Xpitfire/strido/assistant/test/fixtures/content/docs/electronics.md

---
outline: deep
---

# Electronics, wiring and power

The robot has a servo domain and a logic domain.

<ClientOnly><PartsShop /></ClientOnly>

## Ratings and why these parts

| Element | Rating |
|---|---|
| Main fuse (ATO) | 25 A, protects the servo branch trunk |

See the [wiring check](verification/wiring.md#summary).

### Step 6 – Servo UBECs

Two UBECs feed the servos.

```bash
## not a heading
```

## Safety rules

::: warning Never charge unattended
Charge LiPo packs in a bag.
:::
