Xpitfire/strido/assistant/test/fixtures/content/de/docs/electronics.md

# Elektronik, Verdrahtung und Stromversorgung {#electronics-wiring-and-power}

Der Roboter hat einen Servo- und einen Logikzweig.

## Nennwerte und Teilewahl {#ratings-and-why-these-parts}

Die Hauptsicherung (25 A) schützt den Servozweig.
