Xpitfire/strido/docs/catalog.md

# Parts catalogue

> **Status:** generated from the verified CAD assembly and `hardware/bom.yaml` (`make catalog`). Prices are observed offers (EUR incl. VAT, 2026-10-30); re-check before ordering.

**[Download the catalogue & assembly book (A4 PDF)](catalog/strido-catalog.pdf)** — printed parts, purchased parts, hardware bags drawn at 1:1, the shopping plan, tools, every assembly step, wiring and the software appendix.

<ClientOnly><PartsCatalog /></ClientOnly>

Machine-readable: `docs/catalog/parts.json` (also served by the `strido-hardware` MCP server). Items that are not modelled in the CAD (wire, servo extensions, fuses, filament, tape) are listed in the [BOM](bom/README.md).
