Xpitfire/strido/docs/images/exploded.png

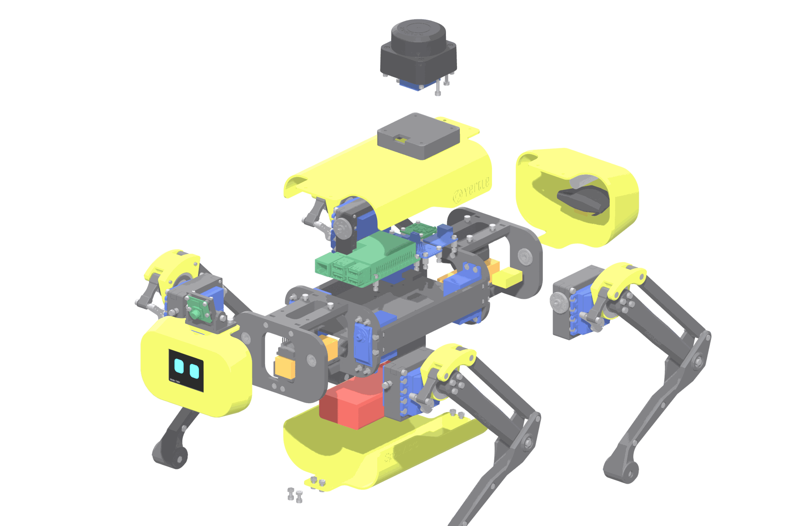
docs/images/exploded.png
