Xpitfire/strido/docs/images/front.png

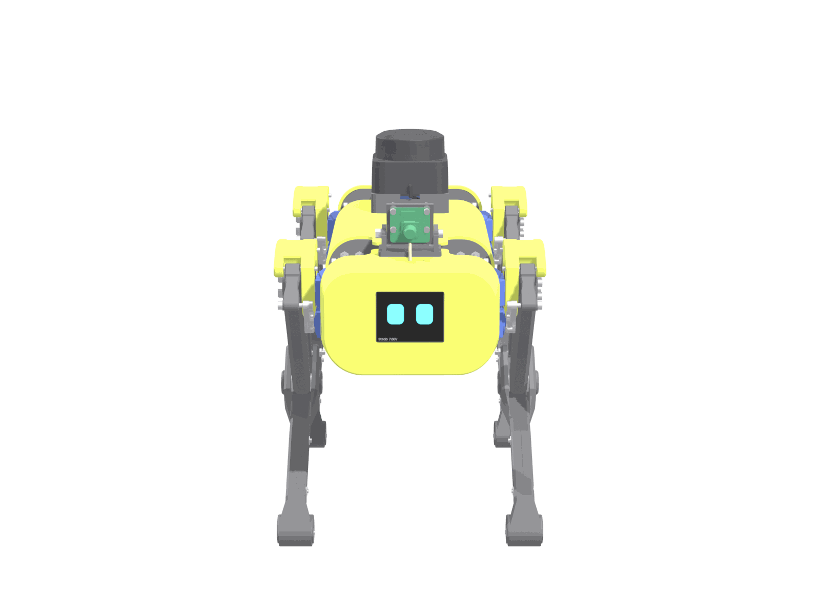
docs/images/front.png
