Xpitfire/strido/docs/images/hero_rear.png

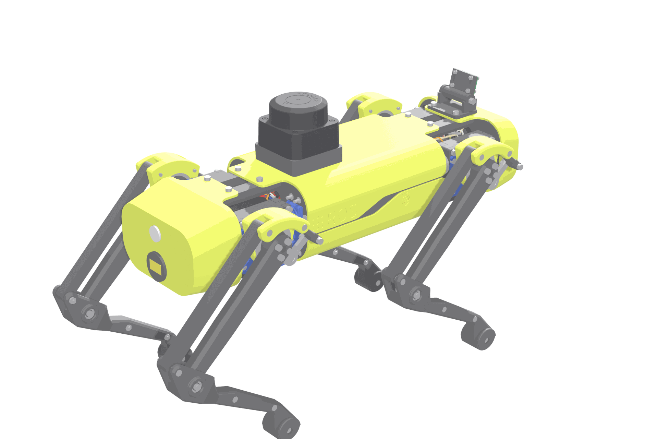
docs/images/hero_rear.png
