Xpitfire/strido/docs/images/section_side.png

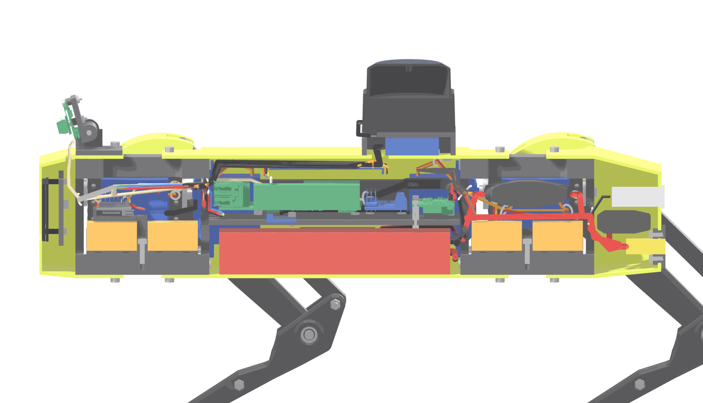
docs/images/section_side.png
