Xpitfire/strido/docs/images/section_top.png

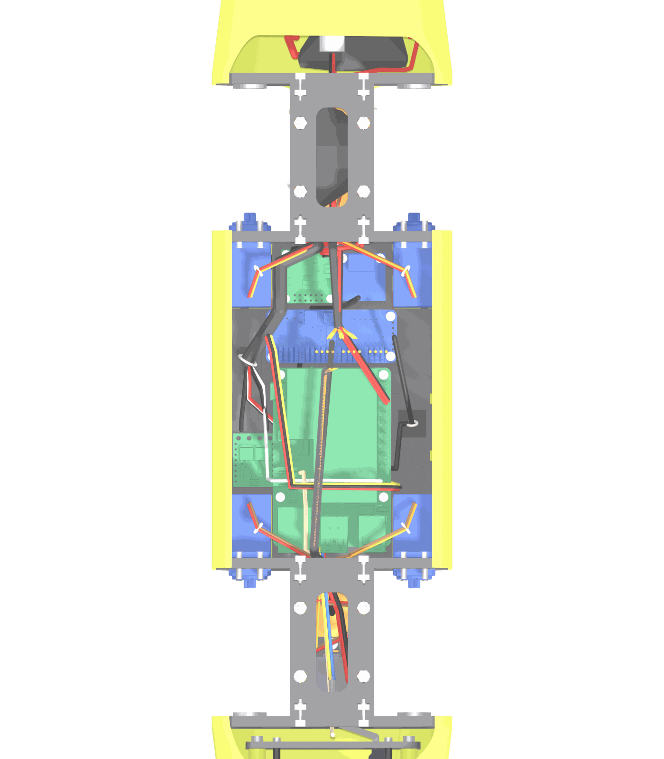
docs/images/section_top.png
