Xpitfire/strido/docs/images/xray_top.png

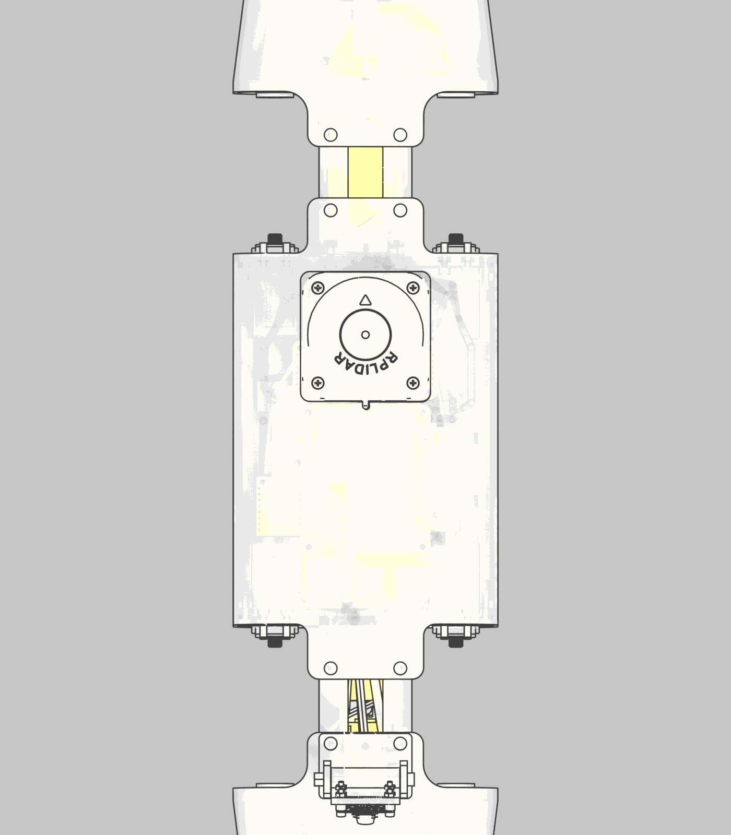
docs/images/xray_top.png
