Xpitfire/strido/docs/viewer/face.png

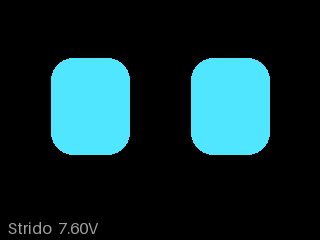
docs/viewer/face.png
