Xpitfire/strido/hardware/print/plates/plate_graphite_07.3mf

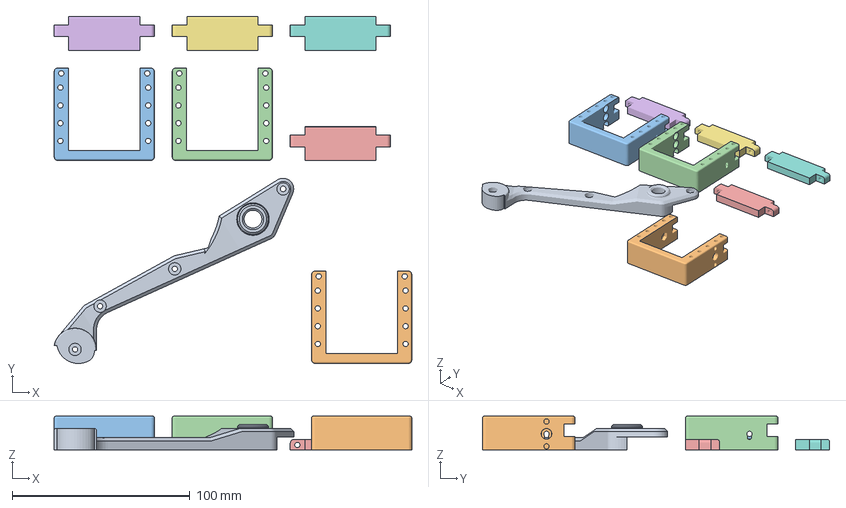
[picture p14: CAD file, 2026-11-10]
hardware/print/plates/plate_graphite_07.3mf
201.2 x 195.2 x 19.0 mm
geometry_0
left_servo_mount_fl.stl
Right_Servo_Mount.stl
right_servo_mount_fr.stl
Servo_Mount_Top_Bracket.stl
Servo_Mount_Top_Bracket.stl_1
Servo_Mount_Top_Bracket.stl_2
Servo_Mount_Top_Bracket.stl_3
