Xpitfire/strido/hardware/print/stl/right_servo_mount.stl

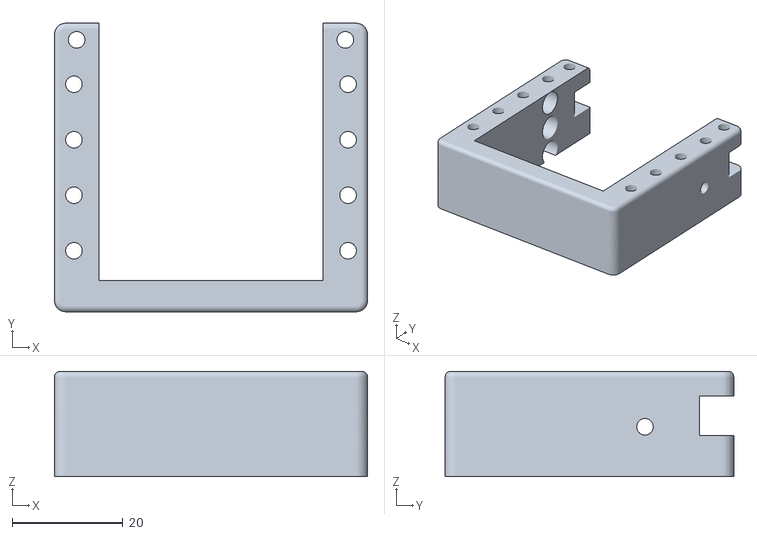
[picture p15: CAD file, 2026-11-10]
hardware/print/stl/right_servo_mount.stl
56.4 x 52.0 x 19.0
