Xpitfire/strido/packages/strido-ntx/src/strido_ntx/robots/models/meshes/RL_calf.stl

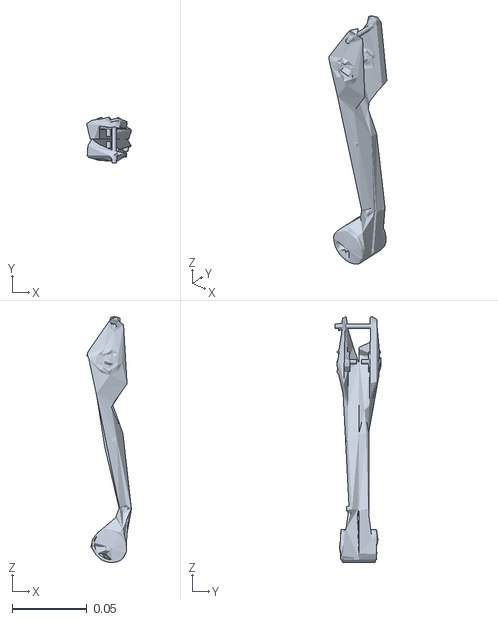
[picture p16: CAD file, 2026-11-10]
packages/strido-ntx/src/strido_ntx/robots/models/meshes/RL_calf.stl
0.03 x 0.0308 x 0.164
