Xpitfire/strido/ros2/strido_description/meshes/RR_thigh.stl

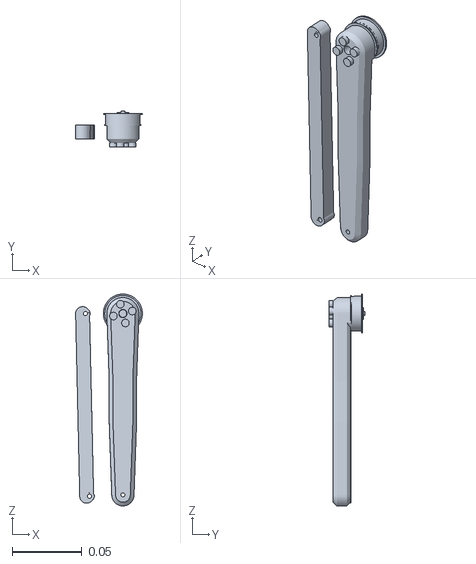
[picture p17: CAD file, 2026-11-10]
ros2/strido_description/meshes/RR_thigh.stl
0.0479 x 0.0258 x 0.152
