Xpitfire/strido/upstream/yertle/design/CAD/Yertle_Single_v2.step

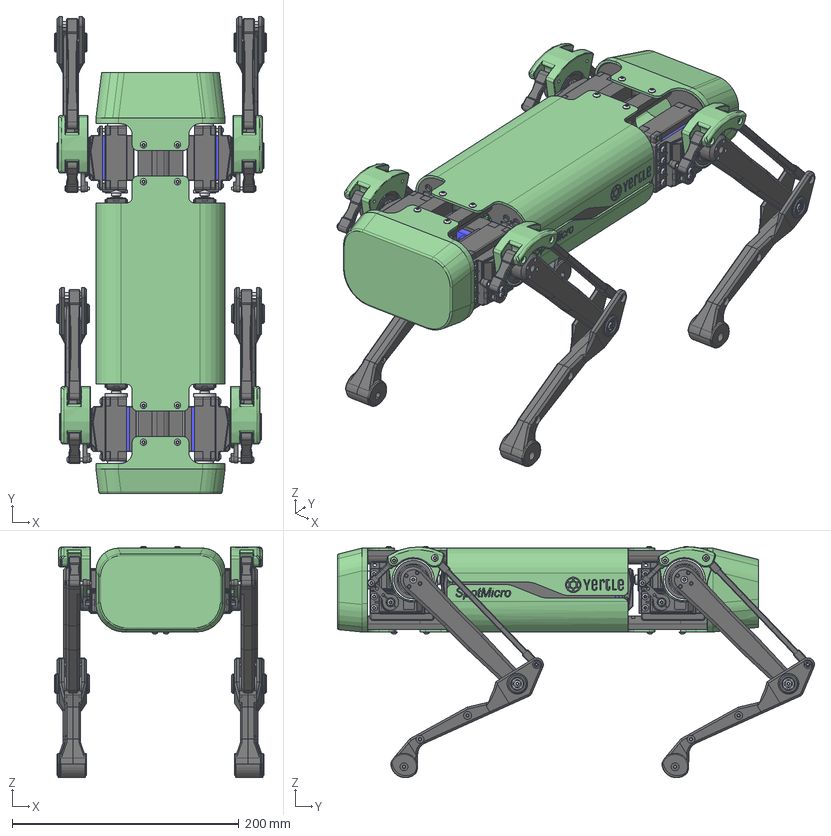
[picture p18: CAD file, 2026-11-10]
upstream/yertle/design/CAD/Yertle_Single_v2.step
187.2 x 421.1 x 204.3 mm
Bottom_Cover_Template
Top_Cover_Template
Rear_Cover (Template)
Rear_Cover (Template)_1
M3 screw x 46
Circuitry_Mountingplate (Template)
PCB, RPi4ModelB
Broadcom BCM2711B0 CPU, RPi4ModelB
2.54 mm DUPONT MALE PIN HEADER, POE, 2X2, RPi4ModelB
2.54 mm DUPONT MALE PIN HEADER, IO, 2X20, RPi4ModelB
Camera Connector, RPi4ModelB
Microphone Plug, RPi4ModelB
Display Connector, RPi4ModelB
Gigabit Ethernet Port, RPi4ModelB
Female Micro HDMI Connector, RPi4ModelB x 2
Female USB Type C Connector, RPi4ModelB
2X USB3.0 PORTS, RPi4ModelB
91D77 D9WHV 778K, 4 GB LPDDR4 SDRAM, RPi4ModelB
Cypress CYW43455 Wireless Module Cover, RPi4ModelB
SD Card Slot, RPi4ModelB
VIA VL805 PCIe USB 3.0 controller, RPi4ModelB
2X USB2.0 PORTS, RPi4ModelB
Broadcom BCM54213PE Gigabit Ethernet Transceiver, RPi4ModelB
MxL7704 Universal PMIC, RPi4ModelB
PCA9685_1
Turnigy_5000mAh_4S__nano_tech_Lipo_Battery
10mm Spacer x 8
UBEC
rodend 5mm big x 2
bl leg_assem_servoholder Bearing right
Shoulder_Joint_Ball_Bearing_Pin x 2
servo_blue x 6
servo arm round x 4
Short Rod
femur right x 2
37mm bearing v3 x 2
Arm Metal Standard x 2
28mm link rod x 2
bushing x 4
bearing_13mm x 4
M3 screw v2 x 6
socket button head cap screw_am_B18.3.4M - 3 x 0.5 x 12 SBHCS --N x 4
bl leg_assem_servoholder Bearing left
Top_Shoulder x 2
Inner_Shoulder x 2
bearing_16m x 4
Chassis_Side x 2
Bottom_Shoulder x 2
rodend 5mm big_1 x 2
bl leg_assem_servoholder Bearing right v8
Shoulder_Joint_Ball_Bearing_Pin v4
servo_blue v1
servo arm round v2
Short Rod_1
femur right v21
37mm bearing v3_1
M3 screw v2 (1)
servo_blue v1 (1)
servo_blue v1 (2)
Arm Metal Standard v2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
