Xpitfire/strido/upstream/yertle/design/STL/Frame/Lower_Shoulder_Frame.stl

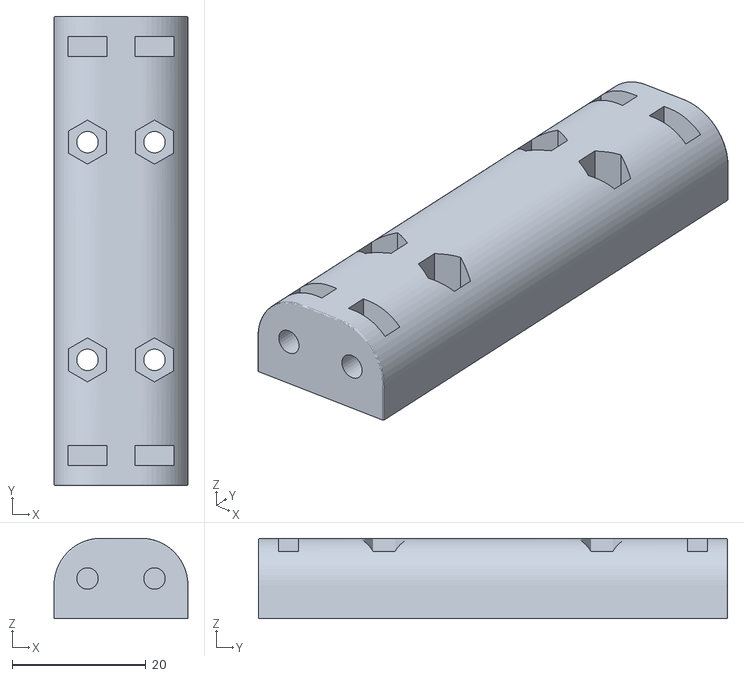
[picture p19: CAD file, 2026-11-10]
upstream/yertle/design/STL/Frame/Lower_Shoulder_Frame.stl
20.0 x 70.0 x 12.0
