Xpitfire/strido/upstream/yertle/design/STL/Legs/Inner_Tibia.stl

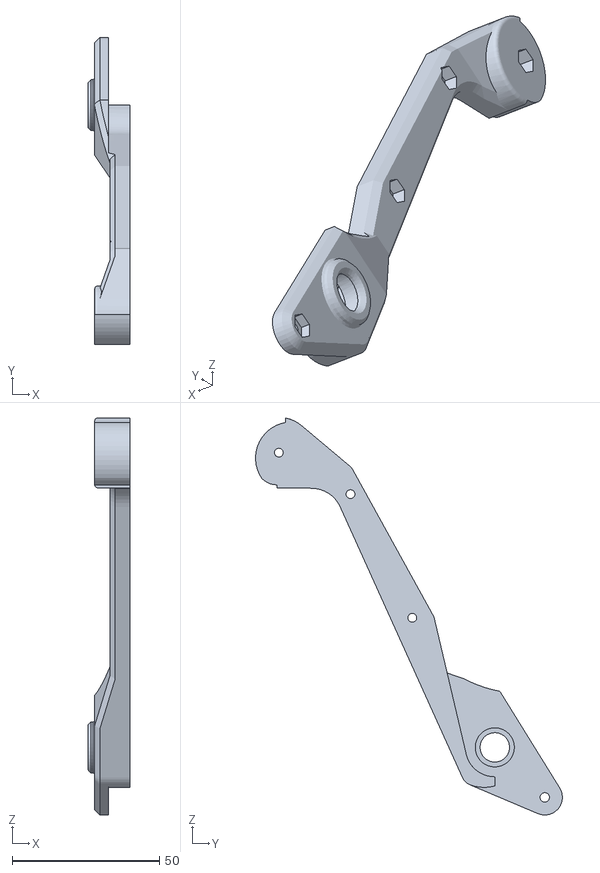
[picture p20: CAD file, 2026-11-10]
upstream/yertle/design/STL/Legs/Inner_Tibia.stl
14.4 x 104.2 x 134.8
