Xpitfire/strido/upstream/yertle/design/STL/Shell/Bottom_Shell.stl

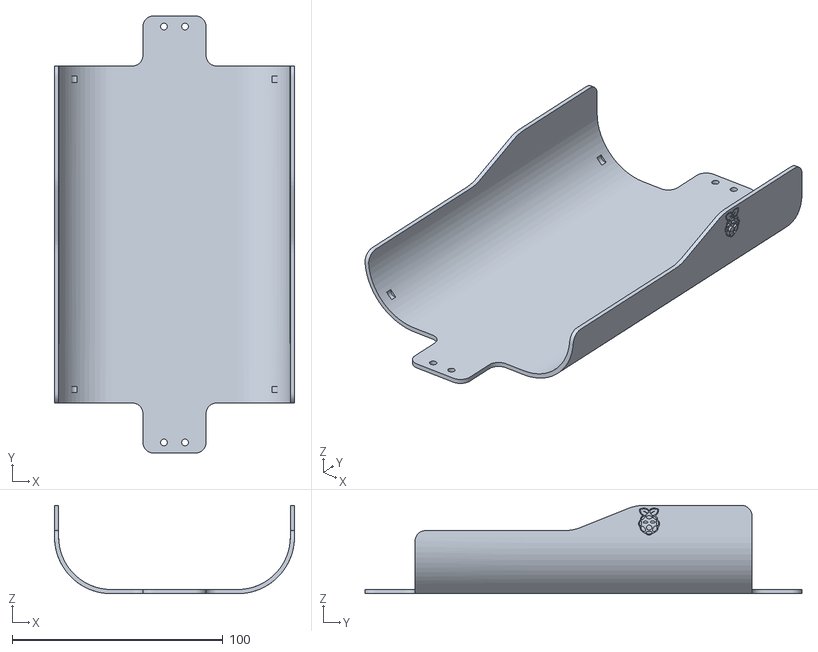
[picture p21: CAD file, 2026-11-10]
upstream/yertle/design/STL/Shell/Bottom_Shell.stl
114.0 x 207.5 x 42.0
