Xpitfire/strido/upstream/yertle/simulation/meshes/lb_shoulder.obj

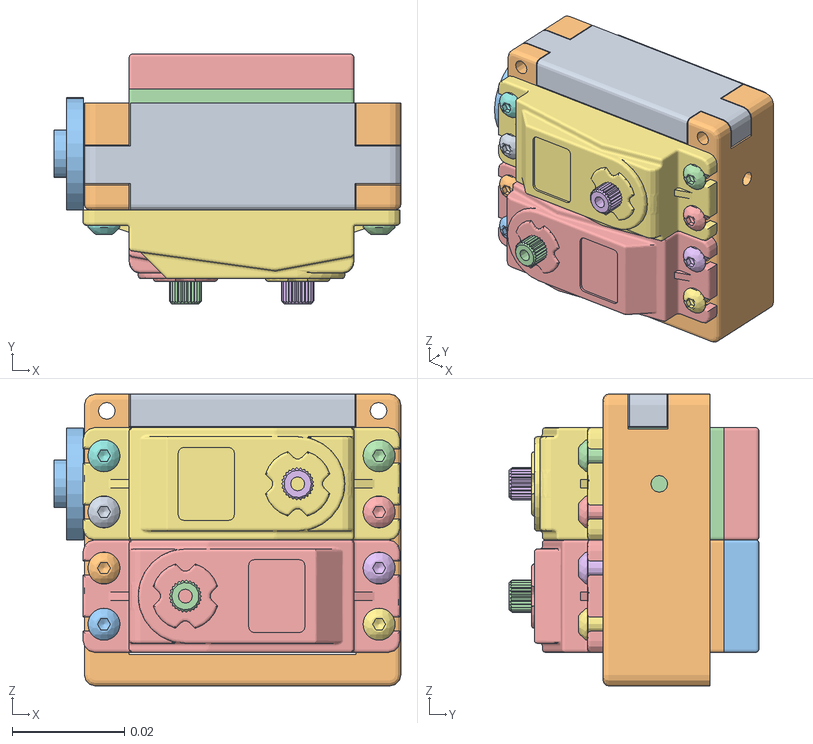
[picture p22: CAD file, 2026-11-10]
upstream/yertle/simulation/meshes/lb_shoulder.obj
0.0618 x 0.0445 x 0.052
