Xpitfire/strido/hardware/print/plates/plate_lime_01.3mf

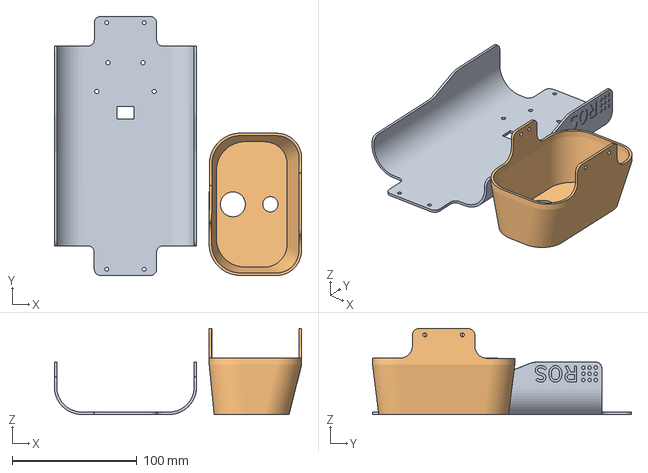
[picture p23: CAD file, 2026-11-10]
hardware/print/plates/plate_lime_01.3mf
198.2 x 207.5 x 68.9 mm
top_shell_sensor.stl
back_shell_button.stl
