Xpitfire/strido/hardware/print/stl/display_bracket.stl

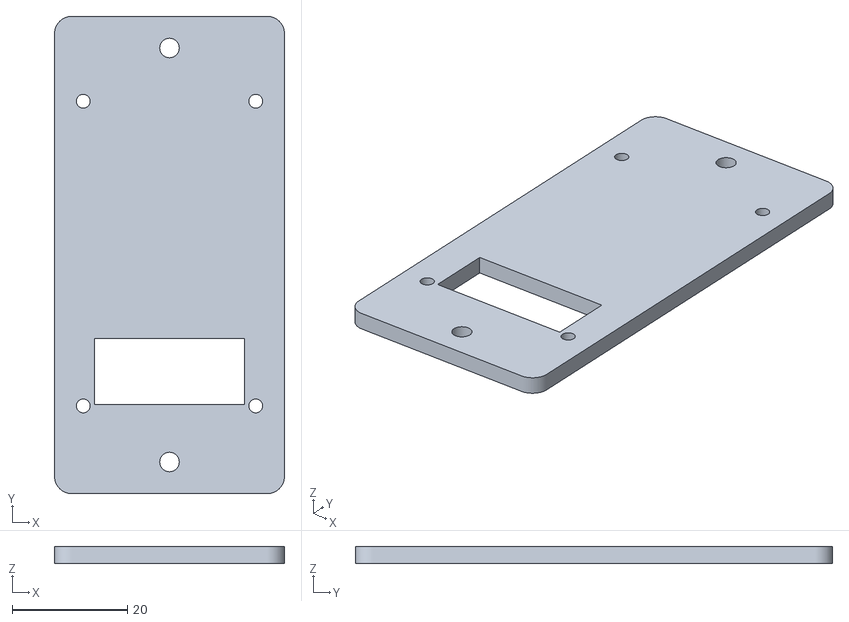
[picture p24: CAD file, 2026-11-10]
hardware/print/stl/display_bracket.stl
40.0 x 83.0 x 3.00
