Xpitfire/strido/packages/strido-ntx/src/strido_ntx/robots/models/meshes/RR_hip.stl

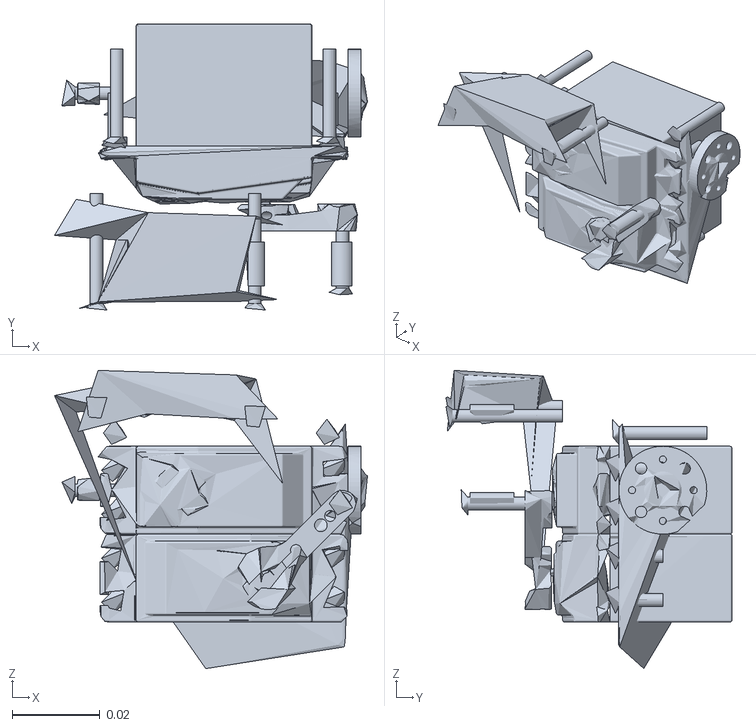
[picture p25: CAD file, 2026-11-10]
packages/strido-ntx/src/strido_ntx/robots/models/meshes/RR_hip.stl
0.0712 x 0.0651 x 0.0678
