Xpitfire/strido/ros2/strido_description/meshes/RR_calf.stl

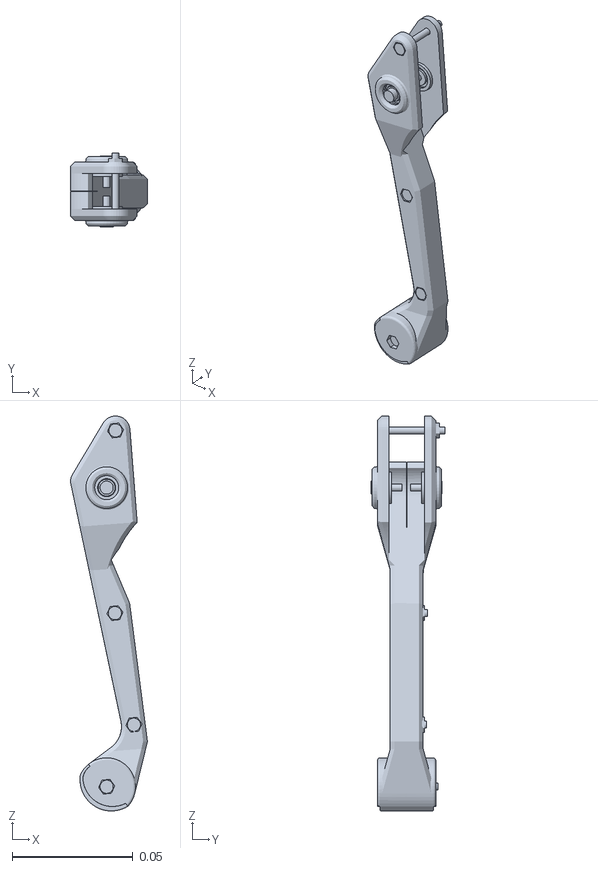
[picture p26: CAD file, 2026-11-10]
ros2/strido_description/meshes/RR_calf.stl
0.0319 x 0.0308 x 0.164
