Xpitfire/strido/upstream/yertle/design/STL/Legs/Left_Shoulder.stl

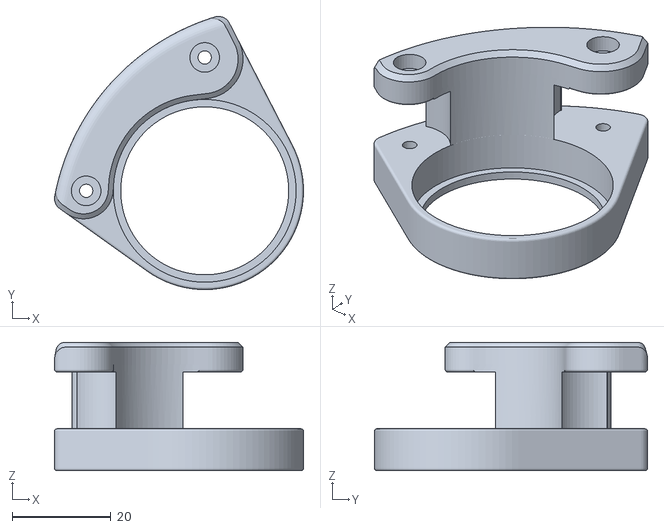
[picture p27: CAD file, 2026-11-10]
upstream/yertle/design/STL/Legs/Left_Shoulder.stl
50.4 x 55.3 x 26.0
