Xpitfire/strido/upstream/yertle/design/STL/Shell/Back_Shell.stl

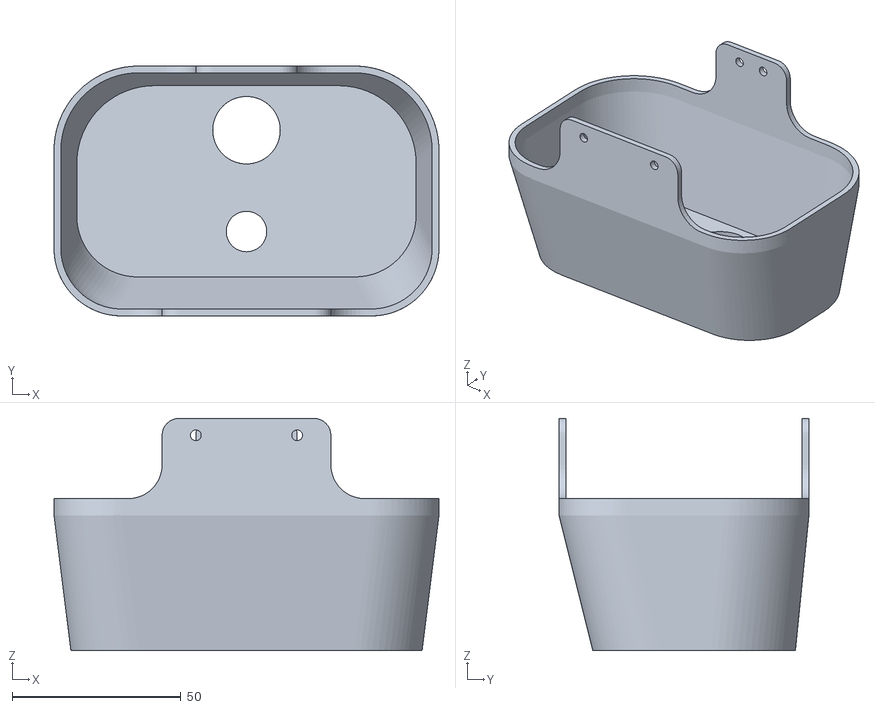
[picture p28: CAD file, 2026-11-10]
upstream/yertle/design/STL/Shell/Back_Shell.stl
114.0 x 74.0 x 68.8
