Xpitfire/strido/hardware/print/plates/plate_graphite_02.3mf

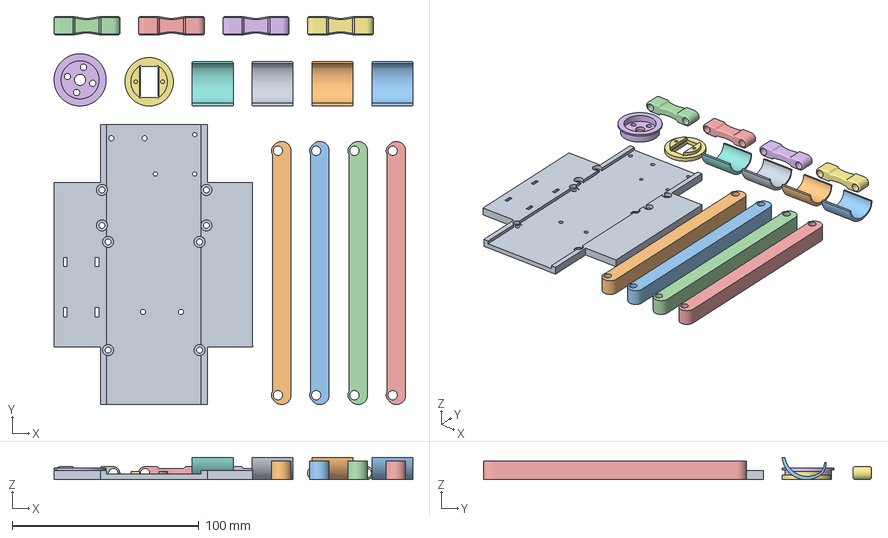
[picture p29: CAD file, 2026-11-10]
hardware/print/plates/plate_graphite_02.3mf
192.4 x 208.0 x 12.0 mm
electronics_deck.stl
stiff_long_link.stl
stiff_long_link.stl_1
stiff_long_link.stl_2
stiff_long_link.stl_3
Femur_Servo_Connector.stl
arming_port_bezel.stl
0196.stl
0196.stl_1
0196.stl_2
0196.stl_3
Short_Link.stl
Short_Link.stl_1
Short_Link.stl_2
Short_Link.stl_3
