Xpitfire/strido/hardware/print/stl/top_shell_sensor.stl

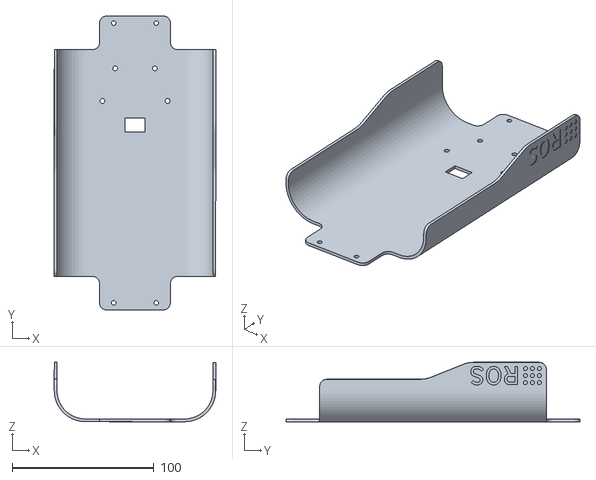
[picture p30: CAD file, 2026-11-10]
hardware/print/stl/top_shell_sensor.stl
114.0 x 207.5 x 42.1
