Xpitfire/strido/packages/strido-ntx/src/strido_ntx/robots/models/meshes/RR_thigh.stl

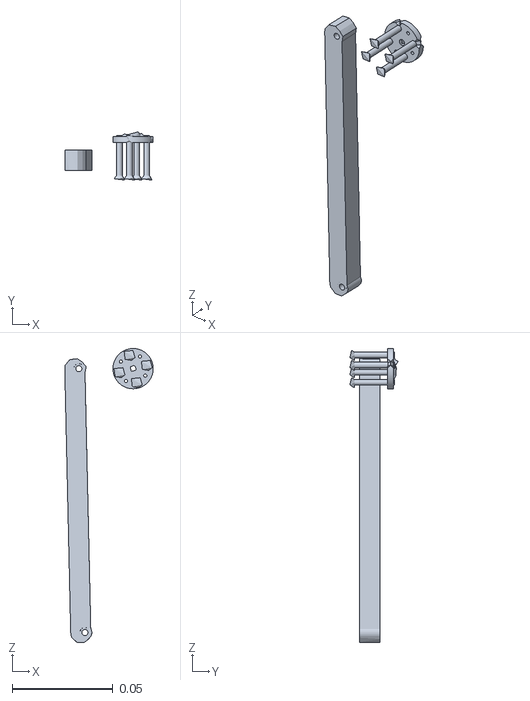
[picture p31: CAD file, 2026-11-10]
packages/strido-ntx/src/strido_ntx/robots/models/meshes/RR_thigh.stl
0.0439 x 0.024 x 0.146
