Xpitfire/strido/ros2/strido_description/meshes/RL_hip.stl

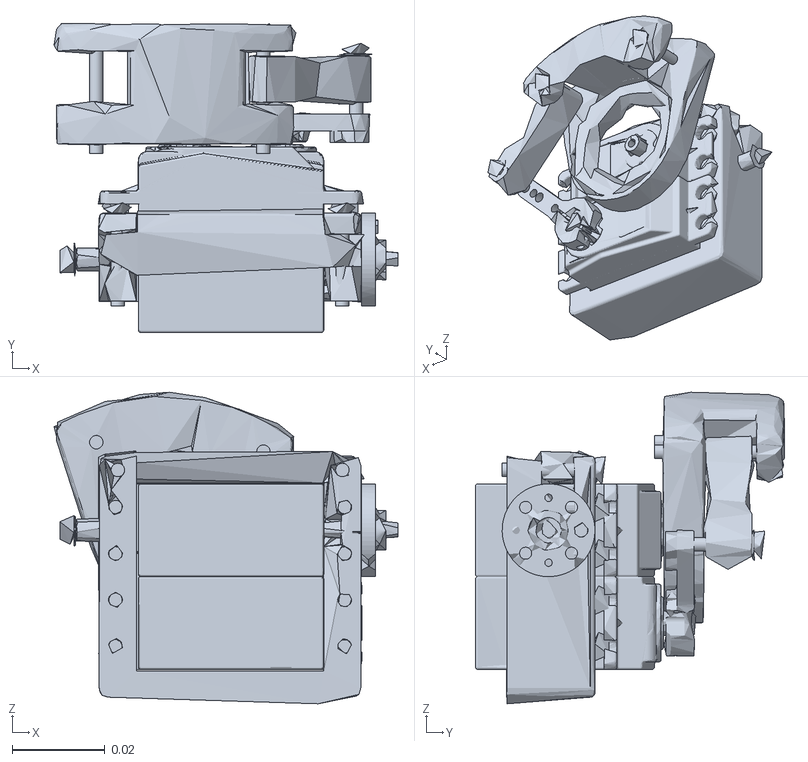
[picture p32: CAD file, 2026-11-10]
ros2/strido_description/meshes/RL_hip.stl
0.0742 x 0.0666 x 0.0672
