Xpitfire/strido/upstream/yertle/design/STL/Frame/Upper_Shoulder_Frame.stl

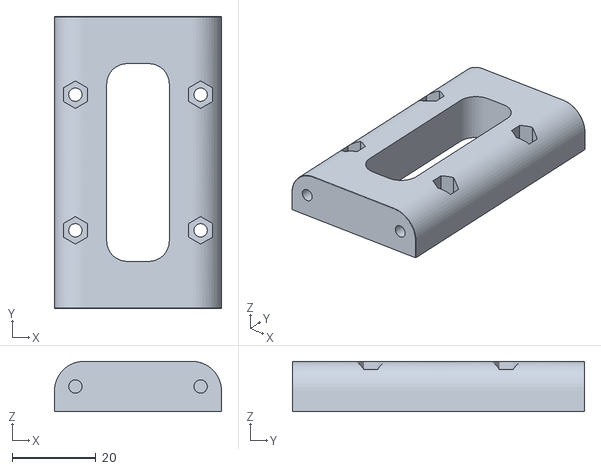
[picture p33: CAD file, 2026-11-10]
upstream/yertle/design/STL/Frame/Upper_Shoulder_Frame.stl
40.0 x 70.0 x 12.0
