Xpitfire/strido/upstream/yertle/design/STL/Legs/Femur_Servo_Connector.stl

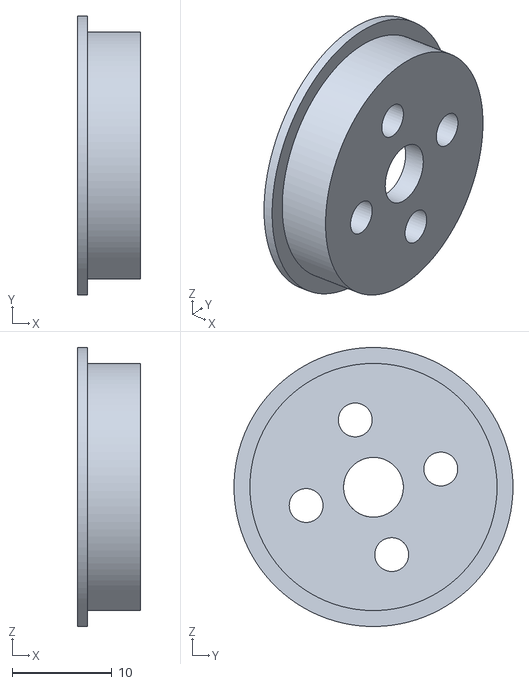
[picture p34: CAD file, 2026-11-10]
upstream/yertle/design/STL/Legs/Femur_Servo_Connector.stl
6.32 x 28.0 x 28.0
