Xpitfire/strido/upstream/yertle/design/STL/Shell/Top_Shell.stl

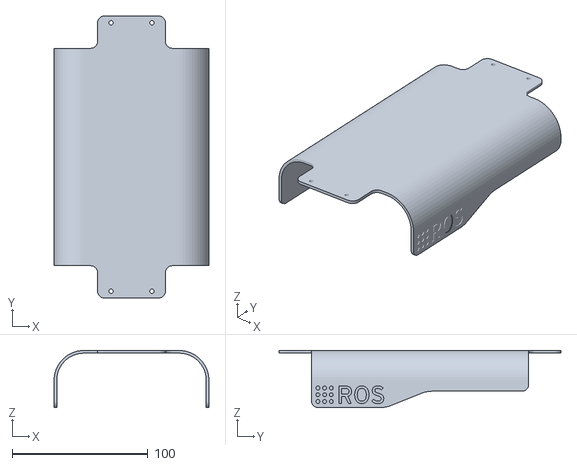
[picture p35: CAD file, 2026-11-10]
upstream/yertle/design/STL/Shell/Top_Shell.stl
114.0 x 207.5 x 42.0
