Xpitfire/strido/hardware/print/plates/plate_graphite_08.3mf

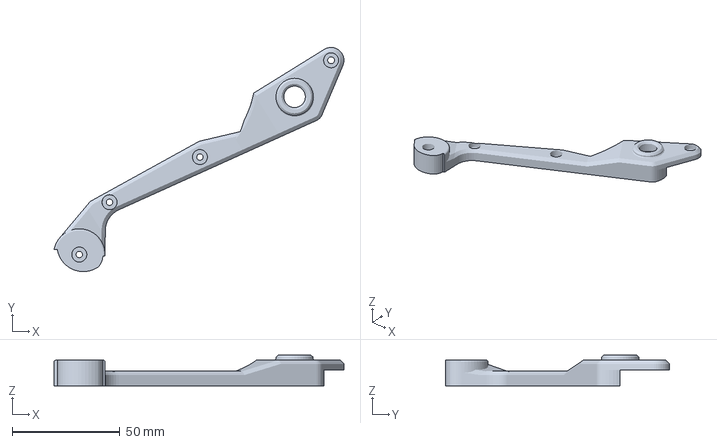
[picture p36: CAD file, 2026-11-10]
hardware/print/plates/plate_graphite_08.3mf
134.8 x 104.2 x 14.4 mm
