Xpitfire/strido/hardware/print/stl/short_link.stl

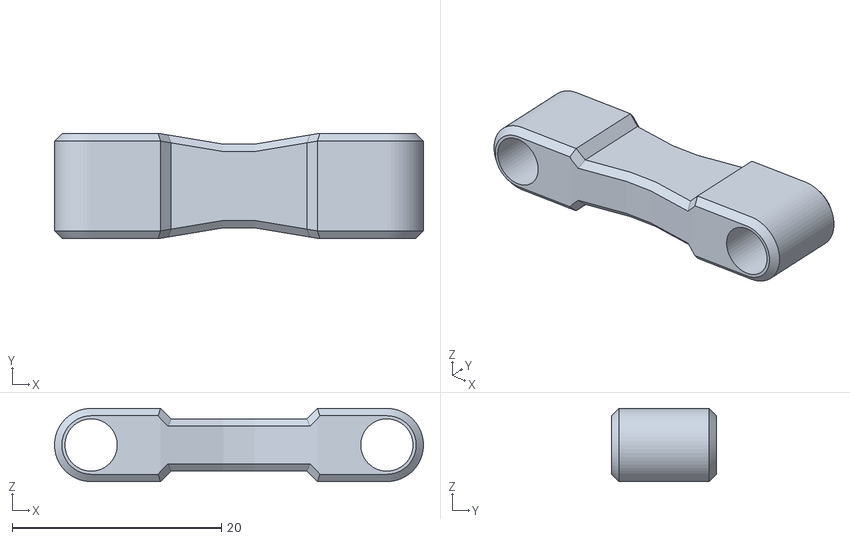
[picture p37: CAD file, 2026-11-10]
hardware/print/stl/short_link.stl
35.3 x 10.0 x 7.00
