Xpitfire/strido/packages/strido-ntx/src/strido_ntx/robots/models/meshes/FR_hip.stl

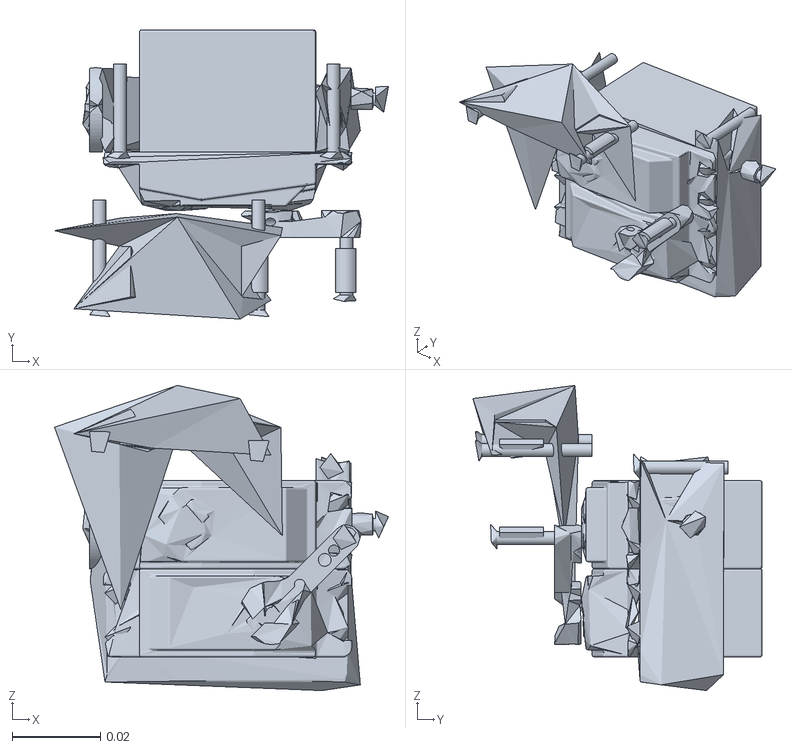
[picture p38: CAD file, 2026-11-10]
packages/strido-ntx/src/strido_ntx/robots/models/meshes/FR_hip.stl
0.0758 x 0.0656 x 0.0692
