Xpitfire/strido/ros2/strido_description/meshes/FR_hip.stl

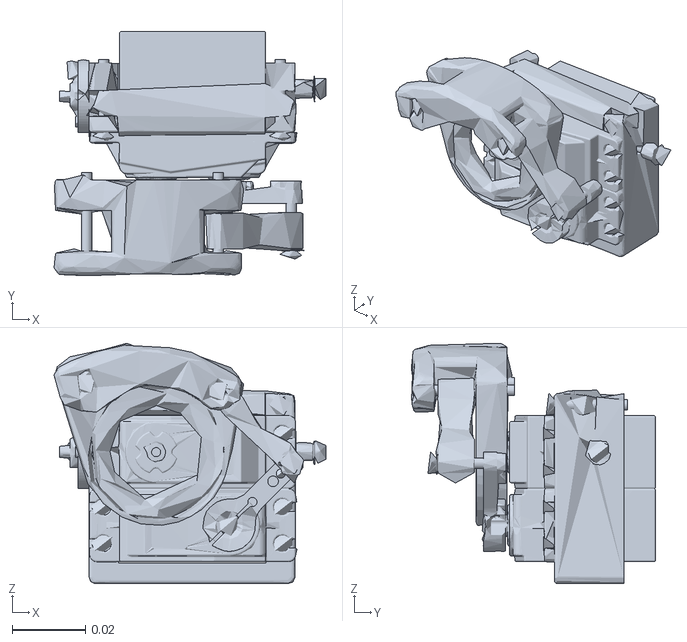
[picture p39: CAD file, 2026-11-10]
ros2/strido_description/meshes/FR_hip.stl
0.0745 x 0.0669 x 0.0658
