Xpitfire/strido/upstream/yertle/design/STL/Frame/Electronics_Mounting_Plate.stl

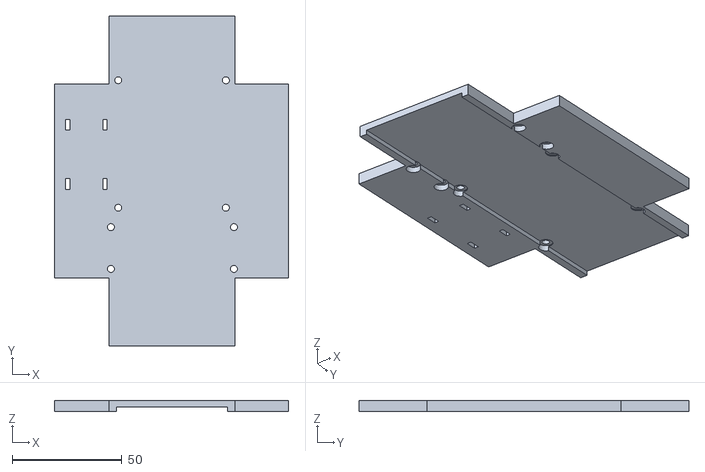
[picture p40: CAD file, 2026-11-10]
upstream/yertle/design/STL/Frame/Electronics_Mounting_Plate.stl
106.5 x 150.0 x 5.00
