Xpitfire/strido/upstream/yertle/design/STL/Legs/Long_Link.stl

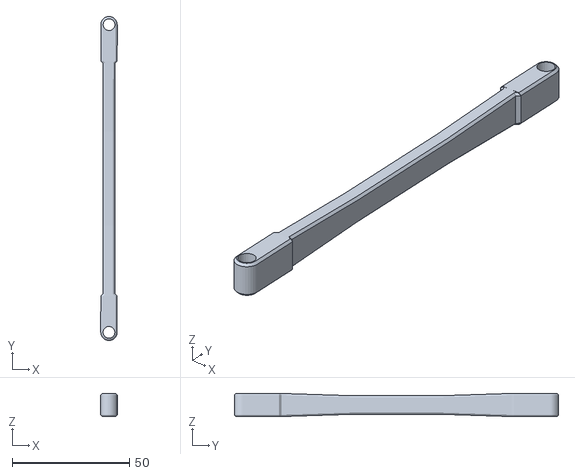
[picture p41: CAD file, 2026-11-10]
upstream/yertle/design/STL/Legs/Long_Link.stl
7.03 x 138.0 x 10.0
