Xpitfire/strido/upstream/yertle/design/STL/Shell/Front_Shell.stl

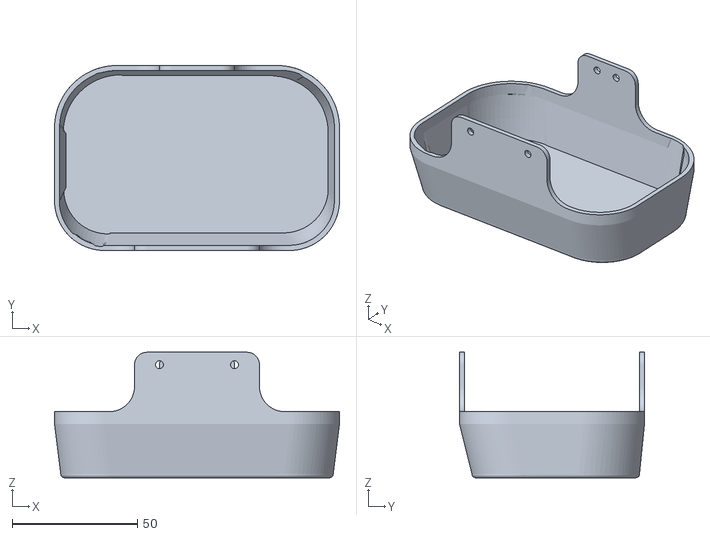
[picture p42: CAD file, 2026-11-10]
upstream/yertle/design/STL/Shell/Front_Shell.stl
114.0 x 74.0 x 50.3
