Xpitfire/strido/hardware/print/stl/camera_mount_base.stl

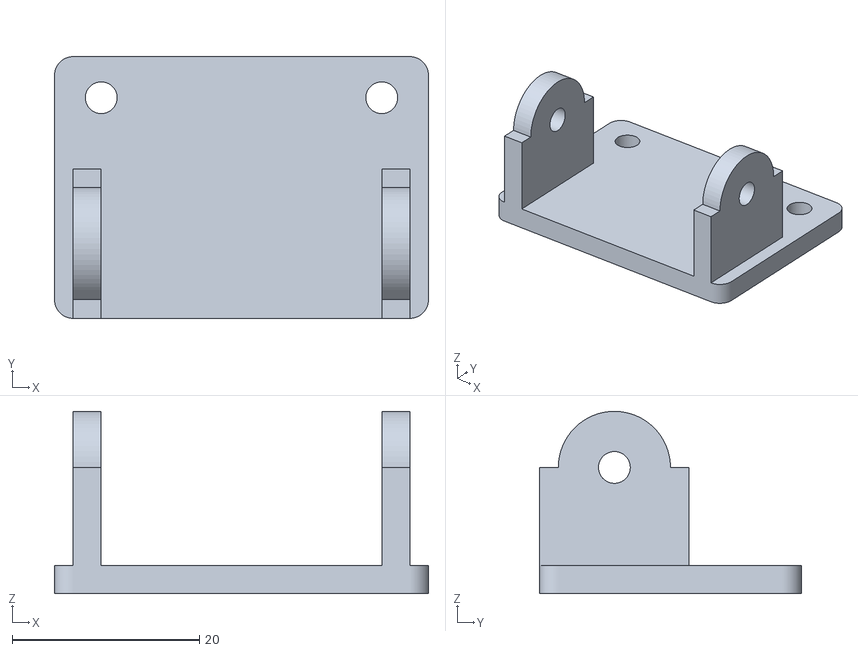
[picture p43: CAD file, 2026-11-10]
hardware/print/stl/camera_mount_base.stl
40.0 x 28.0 x 19.5
