Xpitfire/strido/packages/strido-ntx/src/strido_ntx/robots/models/meshes/base_link.stl

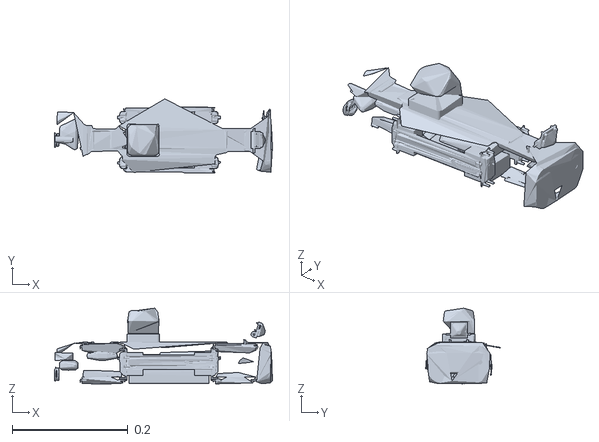
[picture p44: CAD file, 2026-11-10]
packages/strido-ntx/src/strido_ntx/robots/models/meshes/base_link.stl
0.376 x 0.128 x 0.131
