Xpitfire/strido/upstream/yertle/design/STL/Frame/Side_Body_Beam.stl

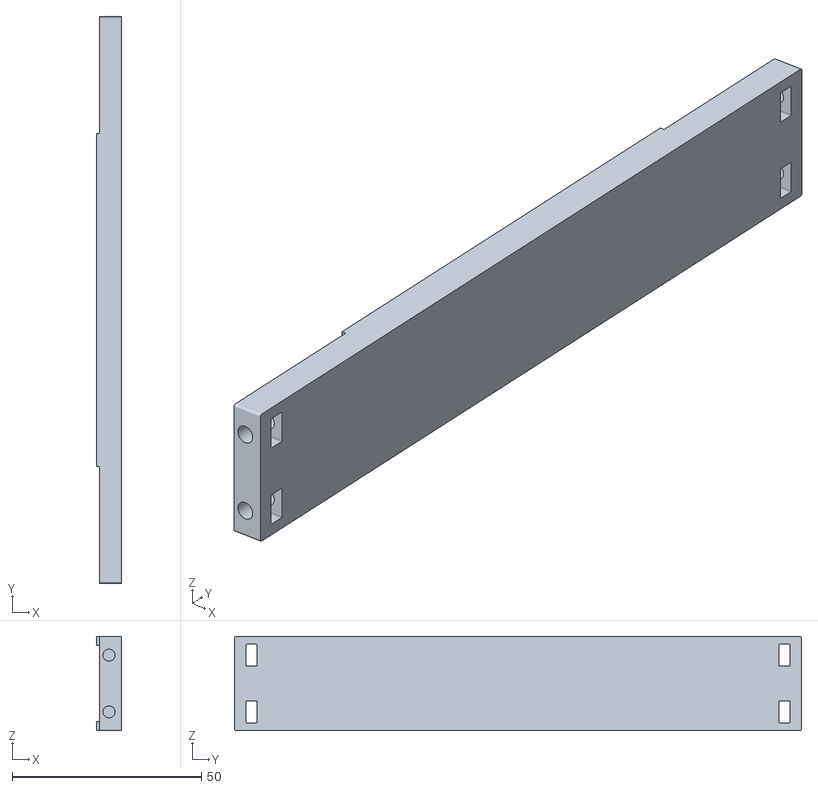
[picture p45: CAD file, 2026-11-10]
upstream/yertle/design/STL/Frame/Side_Body_Beam.stl
6.50 x 150.0 x 25.0
