Xpitfire/strido/upstream/yertle/simulation/meshes/frame.obj

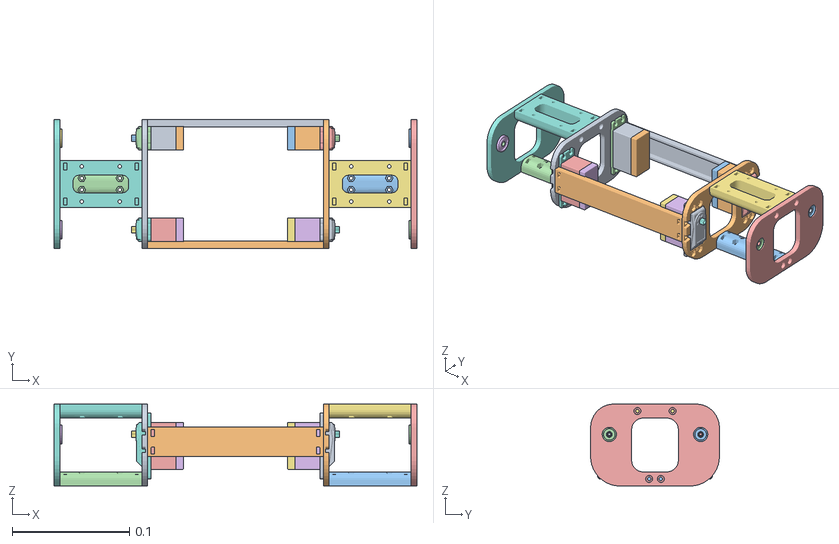
[picture p46: CAD file, 2026-11-10]
upstream/yertle/simulation/meshes/frame.obj
0.31 x 0.11 x 0.07
