Xpitfire/strido/hardware/print/plates/plate_graphite_05.3mf

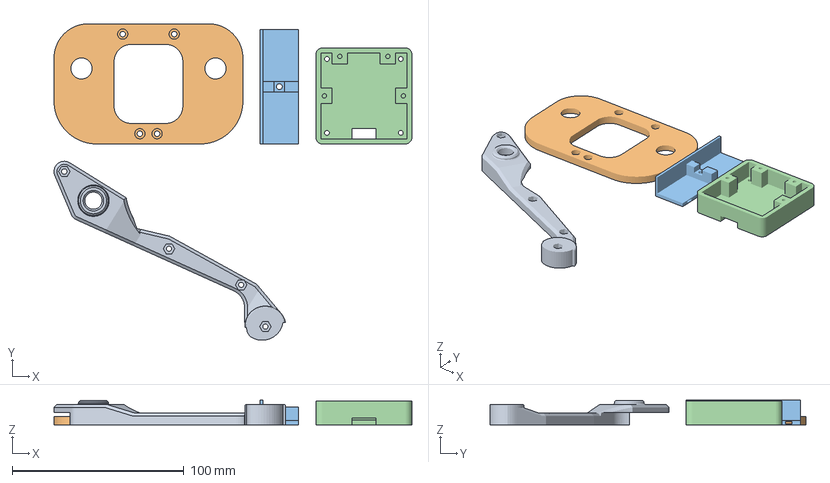
[picture p47: CAD file, 2026-11-10]
hardware/print/plates/plate_graphite_05.3mf
208.4 x 184.2 x 14.5 mm
geometry_0
geometry_1
servo_bus_holder_rear.stl
lidar_pedestal.stl
