Xpitfire/strido/hardware/print/stl/lower_shoulder_frame_front.stl

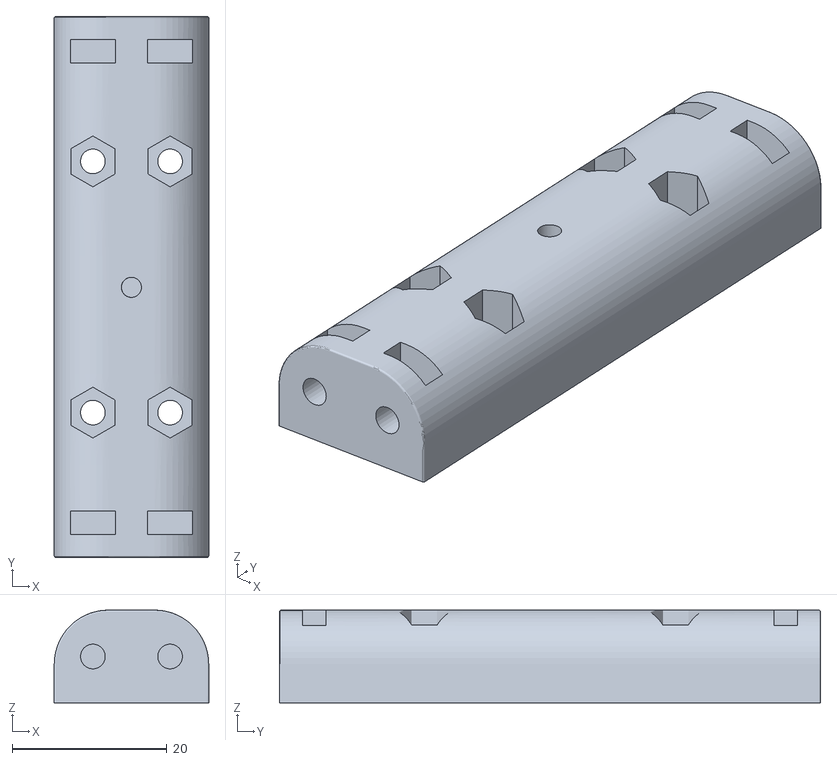
[picture p48: CAD file, 2026-11-10]
hardware/print/stl/lower_shoulder_frame_front.stl
20.0 x 70.0 x 12.0
