Xpitfire/strido/ros2/strido_description/meshes/base_link.stl

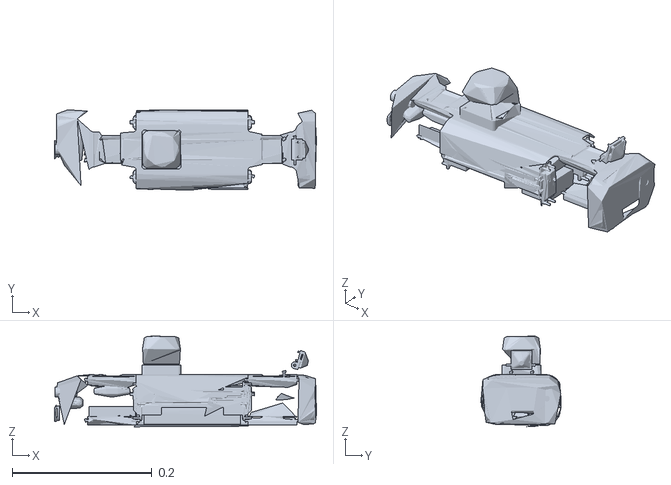
[picture p50: CAD file, 2026-11-10]
ros2/strido_description/meshes/base_link.stl
0.375 x 0.115 x 0.13
