Xpitfire/strido/upstream/yertle/simulation/meshes/tibia.obj

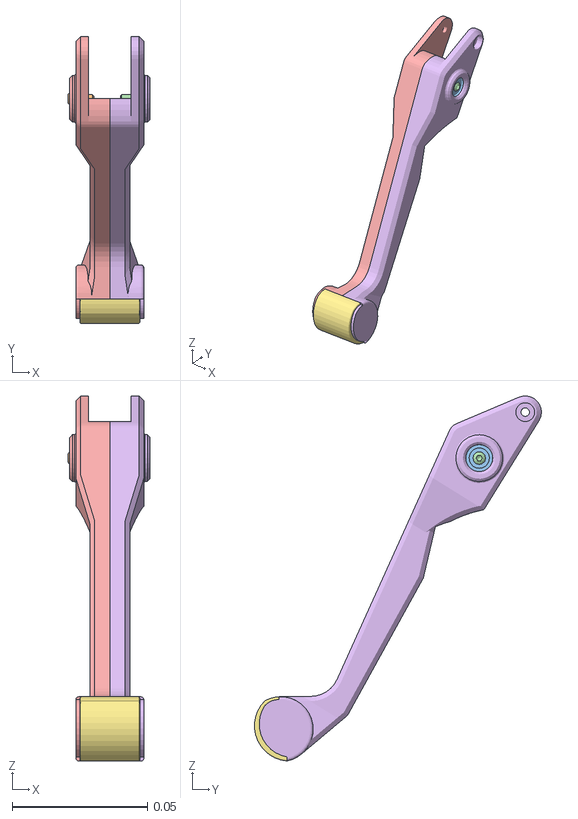
[picture p52: CAD file, 2026-11-10]
upstream/yertle/simulation/meshes/tibia.obj
0.0304 x 0.106 x 0.135
