Xpitfire/strido/hardware/print/plates/plate_lime_02.3mf

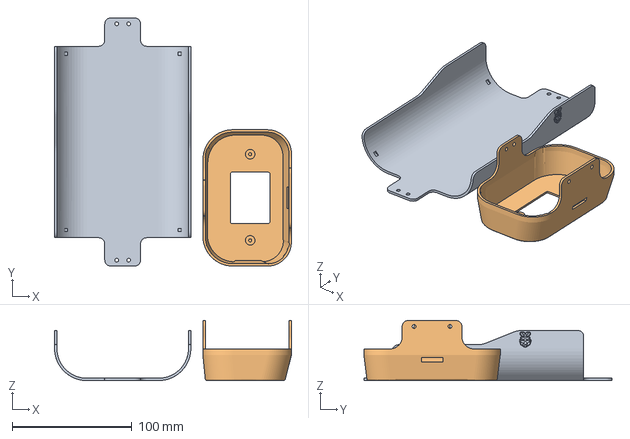
[picture p53: CAD file, 2026-11-10]
hardware/print/plates/plate_lime_02.3mf
198.1 x 207.5 x 50.3 mm
Bottom_Shell.stl
front_shell_display.stl
