Xpitfire/strido/hardware/print/stl/stiff_long_link.stl

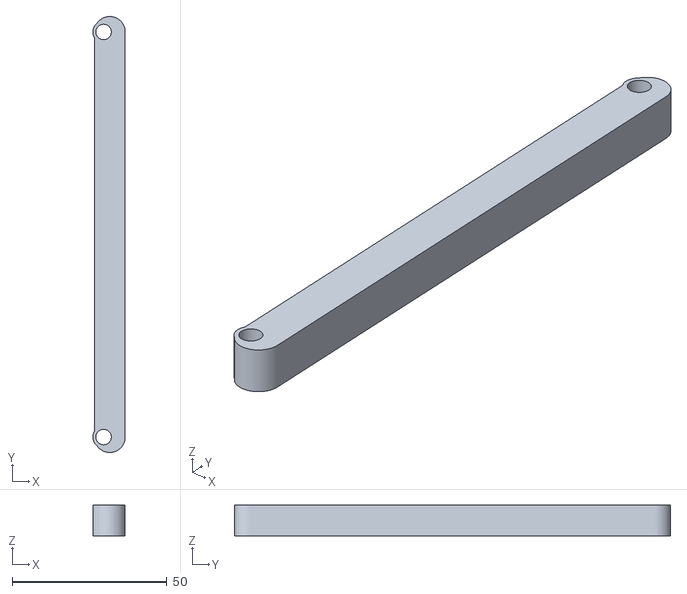
[picture p54: CAD file, 2026-11-10]
hardware/print/stl/stiff_long_link.stl
10.5 x 141.0 x 10.0
