Xpitfire/strido/packages/strido-ntx/src/strido_ntx/robots/models/meshes/FL_hip.stl

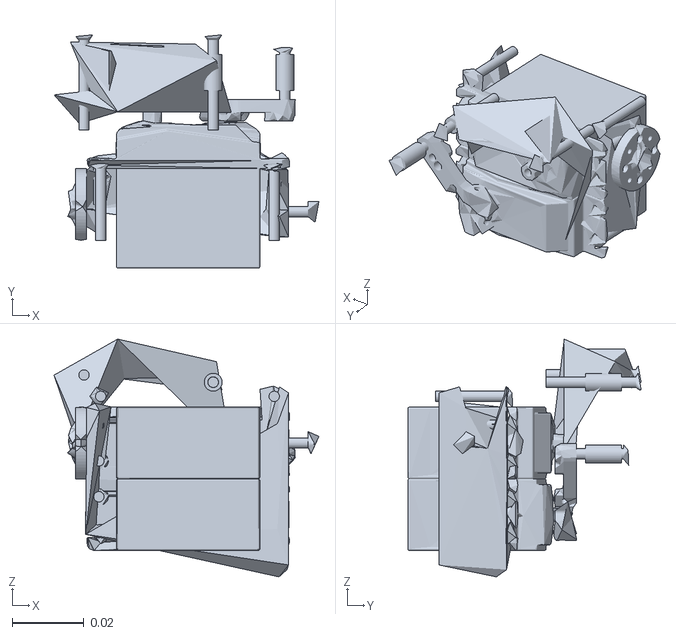
[picture p55: CAD file, 2026-11-10]
packages/strido-ntx/src/strido_ntx/robots/models/meshes/FL_hip.stl
0.0739 x 0.0651 x 0.0663
