Xpitfire/strido/upstream/yertle/design/STL/Legs/Femur.stl

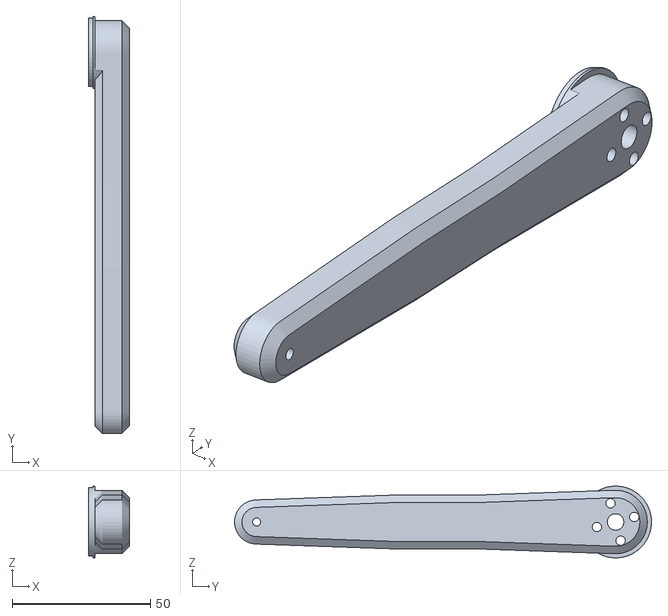
[picture p56: CAD file, 2026-11-10]
upstream/yertle/design/STL/Legs/Femur.stl
14.8 x 151.0 x 26.0
