Xpitfire/strido/upstream/yertle/simulation/meshes/femur.obj

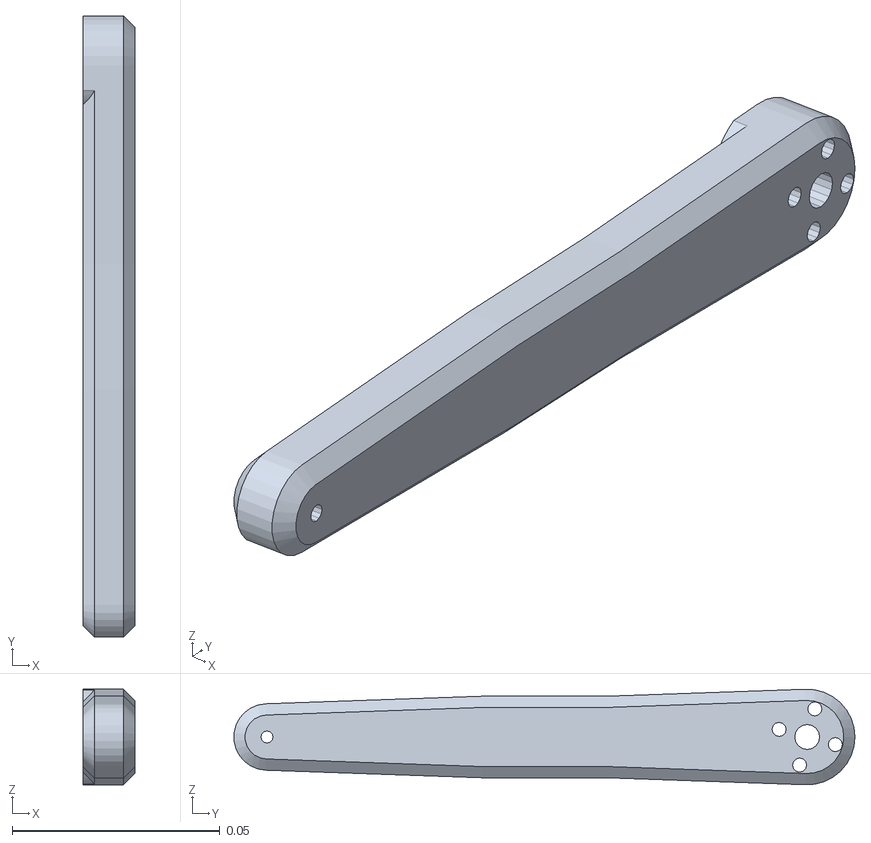
[picture p57: CAD file, 2026-11-10]
upstream/yertle/simulation/meshes/femur.obj
0.0125 x 0.149 x 0.023
