Xpitfire/strido/hardware/print/plates/plate_graphite_03.3mf

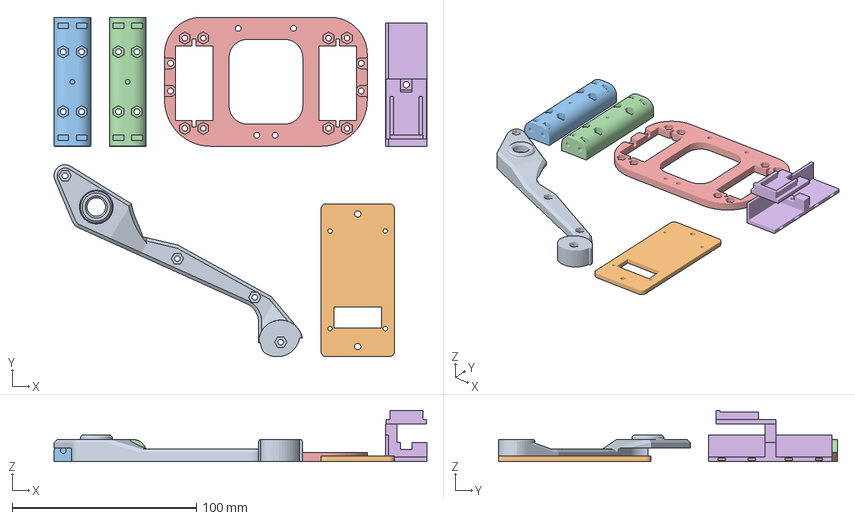
[picture p58: CAD file, 2026-11-10]
hardware/print/plates/plate_graphite_03.3mf
202.4 x 184.2 x 27.8 mm
geometry_0
display_bracket.stl
lower_shoulder_frame_rear.stl
lower_shoulder_frame_front.stl
Inner_Shoulder_Frame.stl
servo_bus_holder_front.stl
