Xpitfire/strido/upstream/yertle/design/STL/Frame/Servo_Mount_Top_Bracket.stl

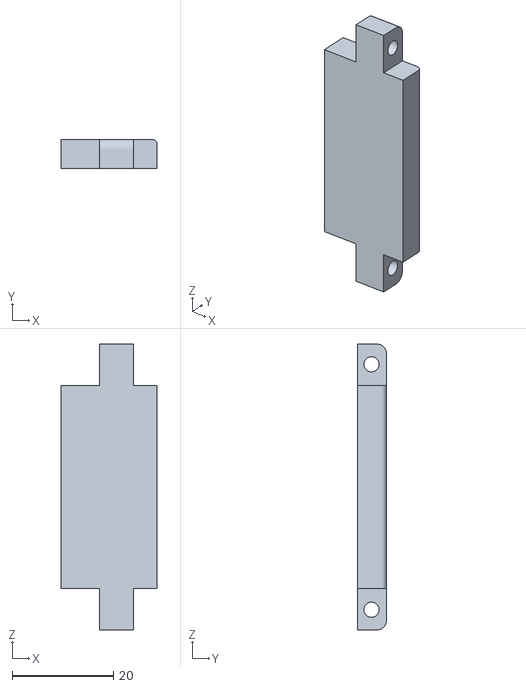
[picture p59: CAD file, 2026-11-10]
upstream/yertle/design/STL/Frame/Servo_Mount_Top_Bracket.stl
19.0 x 5.80 x 56.4
