Xpitfire/strido/upstream/yertle/simulation/meshes/shell.obj

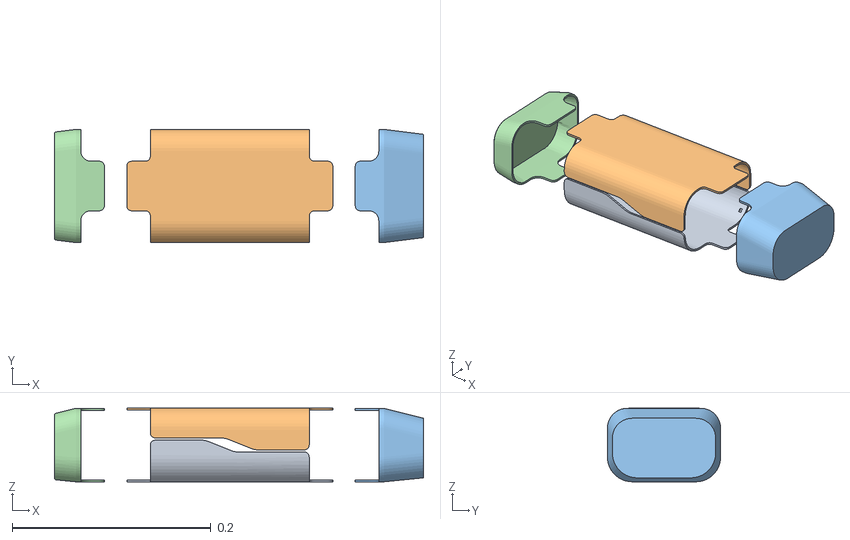
[picture p60: CAD file, 2026-11-10]
upstream/yertle/simulation/meshes/shell.obj
0.372 x 0.114 x 0.0741
Bottom_Cover_Template
MeshBody1
