Xpitfire/strido/hardware/print/plates/plate_graphite_06.3mf

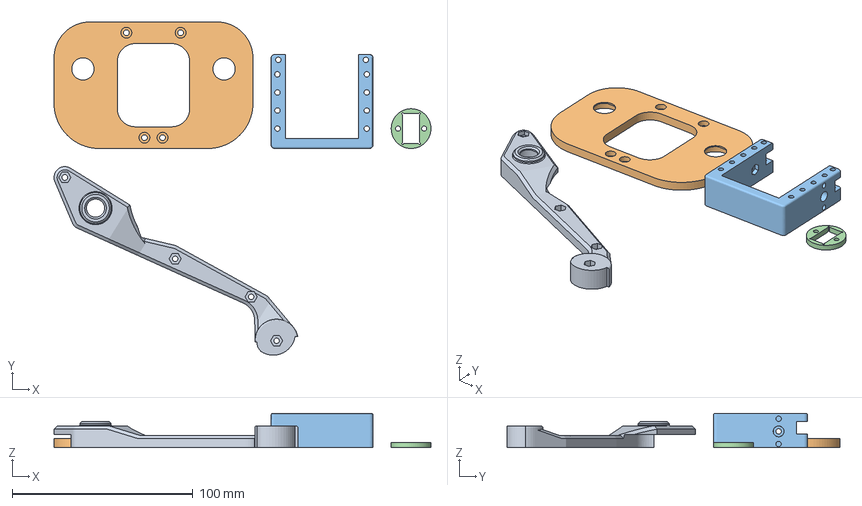
[picture p61: CAD file, 2026-11-10]
hardware/print/plates/plate_graphite_06.3mf
208.4 x 184.2 x 19.0 mm
geometry_0
geometry_1
Left_Servo_Mount.stl
arming_port_ring.stl
