Xpitfire/strido/upstream/yertle/design/STL/Frame/Inner_Shoulder_Frame.stl

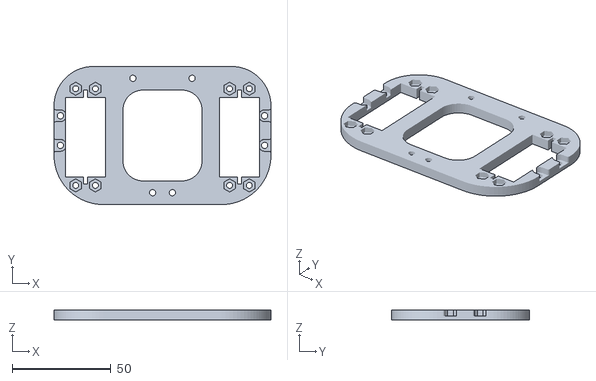
[picture p62: CAD file, 2026-11-10]
upstream/yertle/design/STL/Frame/Inner_Shoulder_Frame.stl
110.0 x 70.0 x 5.00
