Xpitfire/strido/hardware/print/plates/plate_graphite_04.3mf

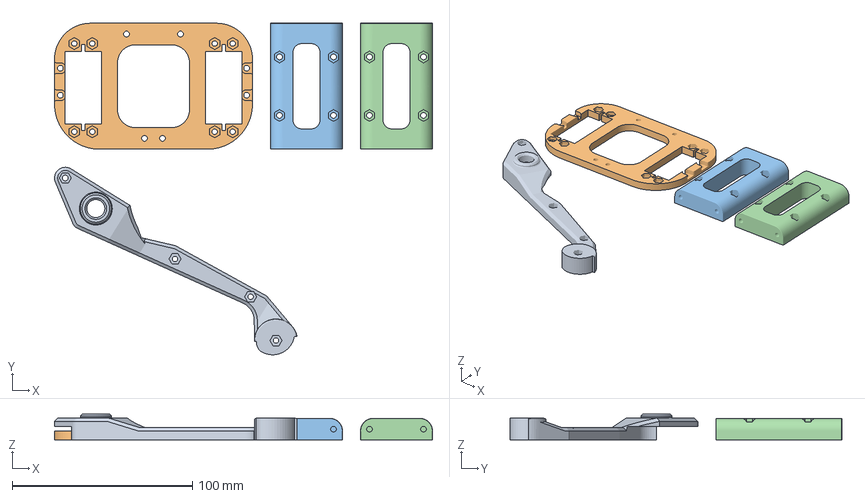
[picture p63: CAD file, 2026-11-10]
hardware/print/plates/plate_graphite_04.3mf
210.0 x 184.2 x 14.4 mm
geometry_0
Inner_Shoulder_Frame.stl
Upper_Shoulder_Frame.stl
Upper_Shoulder_Frame.stl_1
