Xpitfire/strido/packages/strido-ntx/src/strido_ntx/robots/models/meshes/RL_thigh.stl

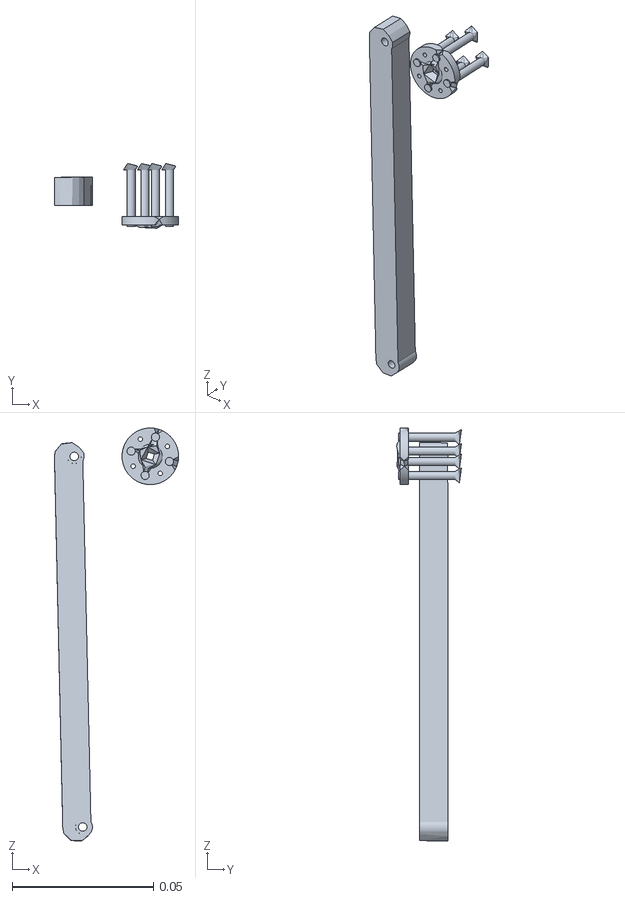
[picture p64: CAD file, 2026-11-10]
packages/strido-ntx/src/strido_ntx/robots/models/meshes/RL_thigh.stl
0.0439 x 0.023 x 0.146
