Xpitfire/strido/packages/strido-ntx/src/strido_ntx/robots/models/meshes/RL_hip.stl

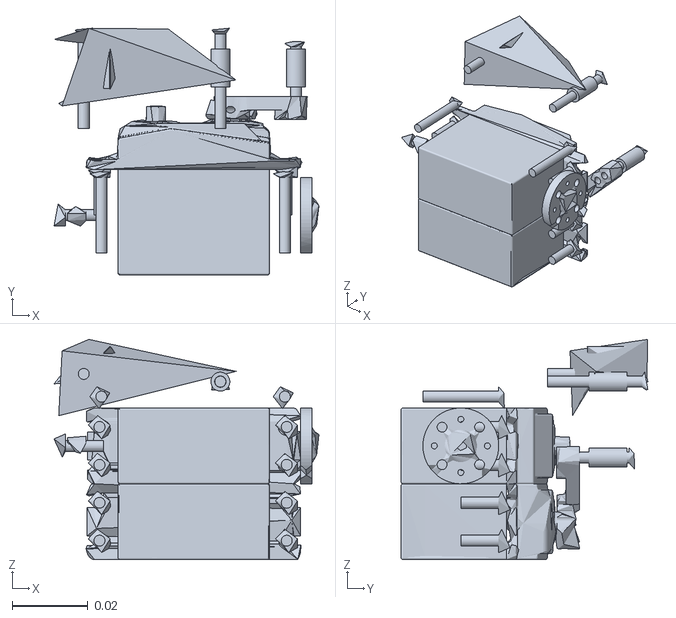
[picture p65: CAD file, 2026-11-10]
packages/strido-ntx/src/strido_ntx/robots/models/meshes/RL_hip.stl
0.0699 x 0.0651 x 0.0581
