Xpitfire/strido/hardware/print/plates/plate_graphite_01.3mf

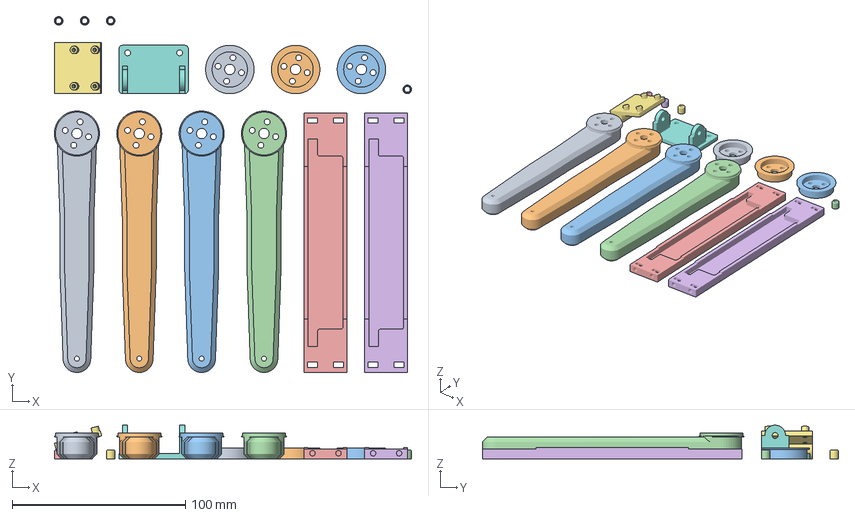
[picture p66: CAD file, 2026-11-10]
hardware/print/plates/plate_graphite_01.3mf
206.3 x 205.6 x 19.5 mm
Femur.stl
Femur.stl_1
Femur.stl_2
Femur.stl_3
Side_Body_Beam.stl
Side_Body_Beam.stl_1
camera_tilt_plate.stl
camera_mount_base.stl
Femur_Servo_Connector.stl
Femur_Servo_Connector.stl_1
Femur_Servo_Connector.stl_2
0154.stl
0154.stl_1
0154.stl_2
0154.stl_3
