Xpitfire/strido/hardware/print/plates/plate_lime_03.3mf

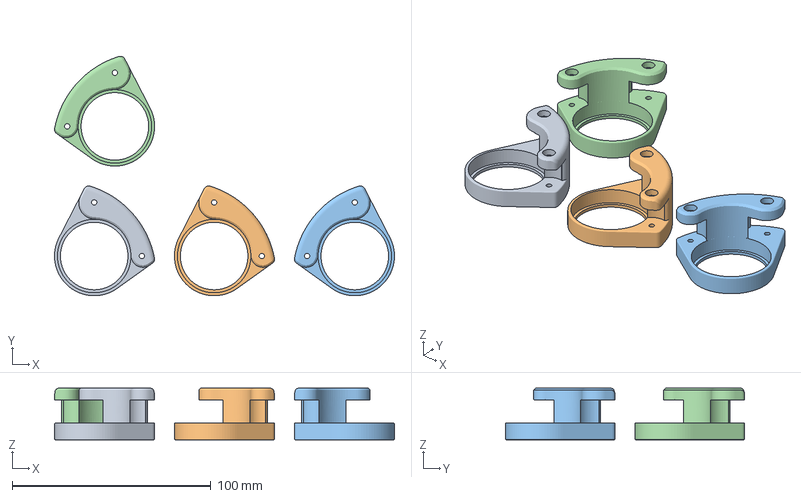
[picture p67: CAD file, 2026-11-10]
hardware/print/plates/plate_lime_03.3mf
171.2 x 120.6 x 26.0 mm
Right_Shoulder.stl
Right_Shoulder.stl_1
Left_Shoulder.stl
Left_Shoulder.stl_1
