Xpitfire/strido/hardware/print/stl/electronics_deck.stl

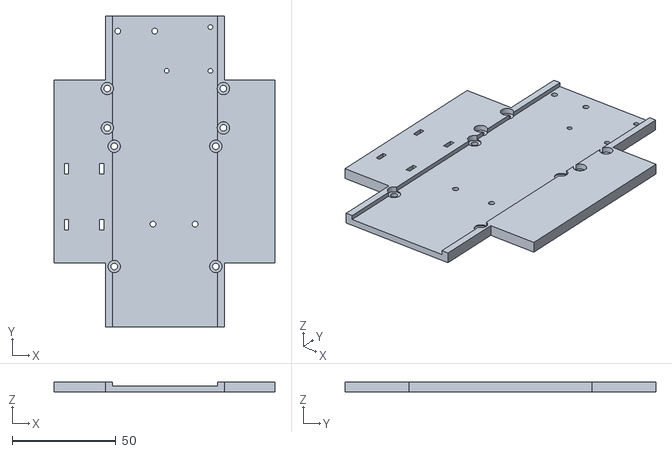
[picture p68: CAD file, 2026-11-10]
hardware/print/stl/electronics_deck.stl
106.5 x 150.0 x 5.02
