Xpitfire/strido/hardware/print/stl/foot_spacer.stl

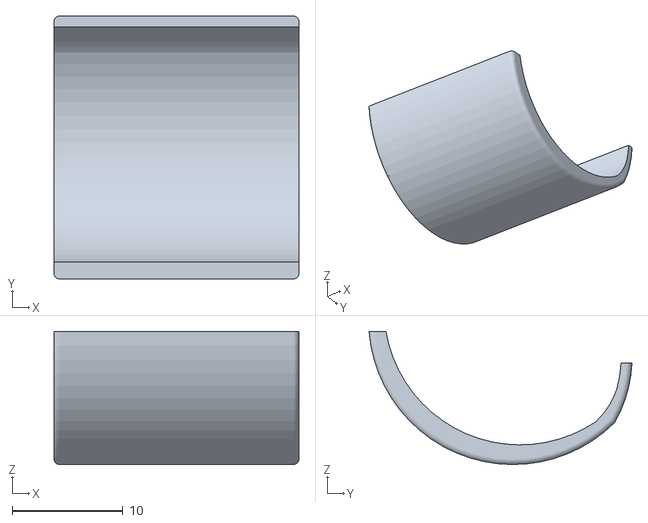
[picture p69: CAD file, 2026-11-10]
hardware/print/stl/foot_spacer.stl
22.1 x 23.7 x 12.0
