Xpitfire/strido/hardware/print/stl/lidar_pedestal.stl

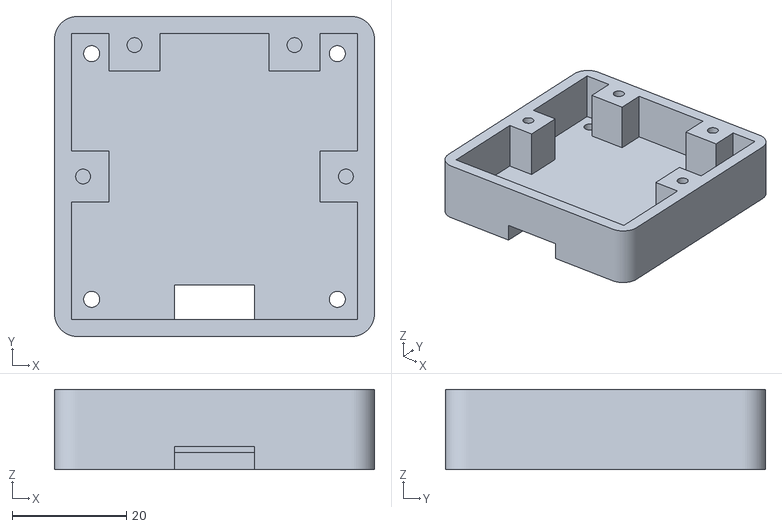
[picture p70: CAD file, 2026-11-10]
hardware/print/stl/lidar_pedestal.stl
56.0 x 56.0 x 14.0
