Xpitfire/strido/hardware/print/stl/hip_bearing_pin.stl

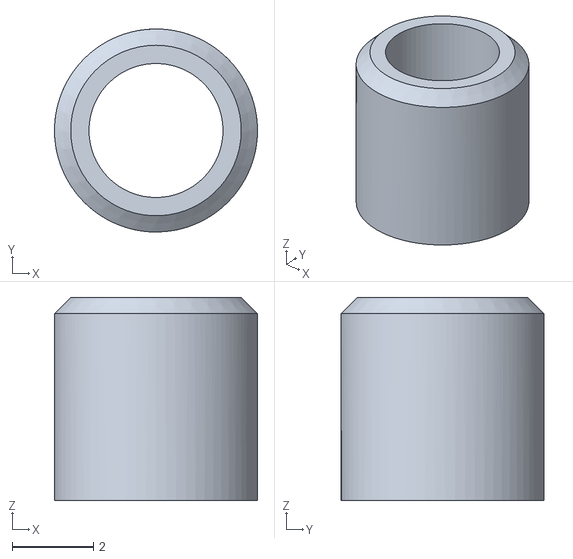
[picture p71: CAD file, 2026-11-10]
hardware/print/stl/hip_bearing_pin.stl
5.00 x 5.00 x 5.00
