Xpitfire/strido/hardware/print/stl/servo_bus_holder_rear.stl

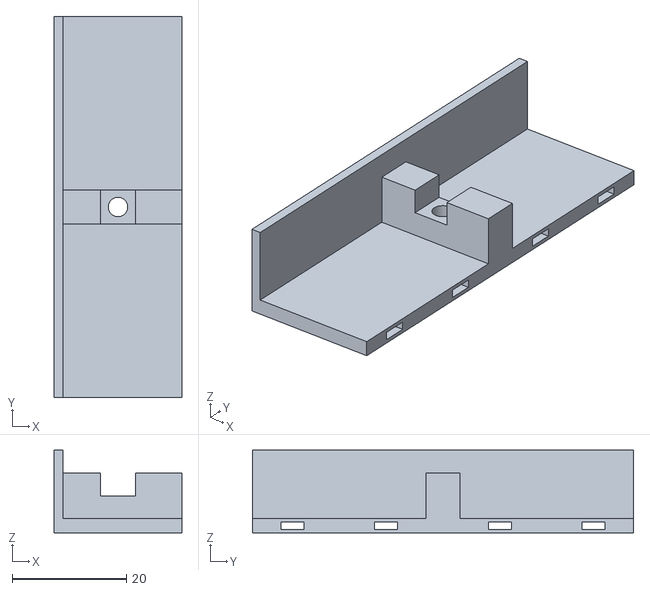
[picture p72: CAD file, 2026-11-10]
hardware/print/stl/servo_bus_holder_rear.stl
22.4 x 66.8 x 14.5
