Xpitfire/strido/hardware/print/stl/camera_tilt_plate.stl

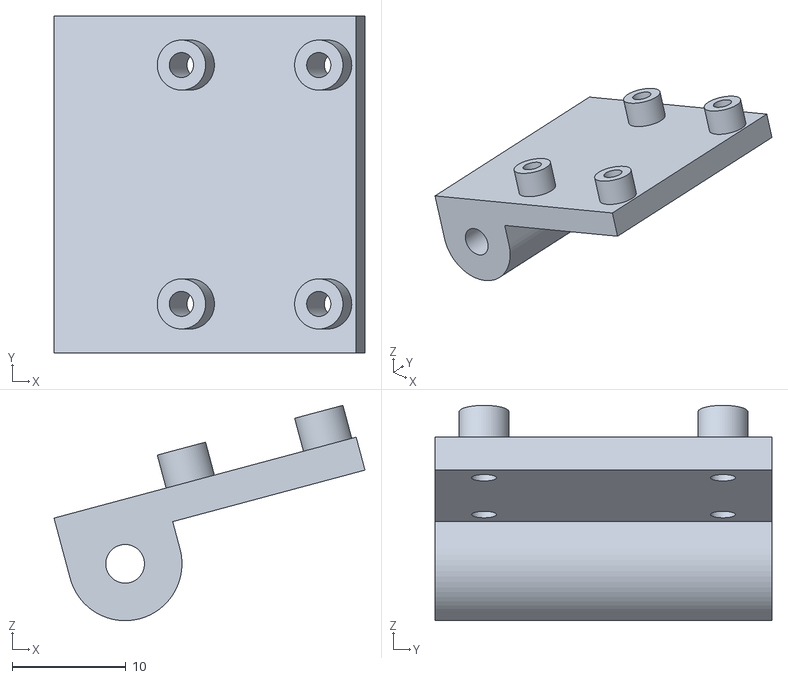
[picture p73: CAD file, 2026-11-10]
hardware/print/stl/camera_tilt_plate.stl
27.3 x 29.6 x 18.9
