Xpitfire/strido/hardware/print/stl/front_shell_display.stl

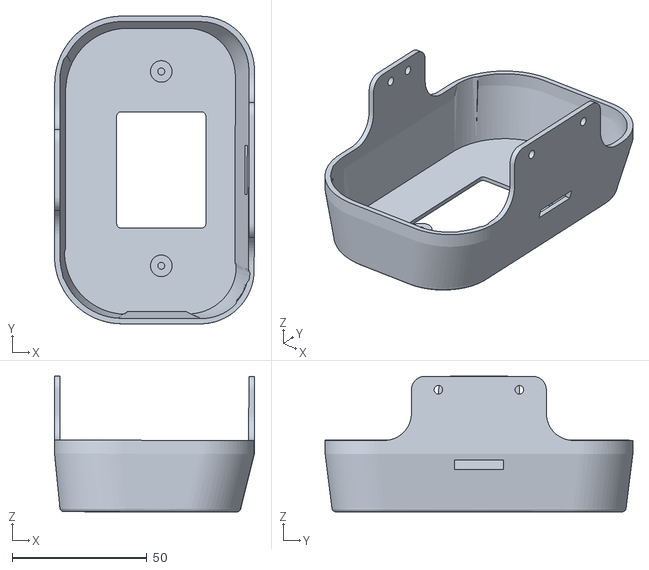
[picture p74: CAD file, 2026-11-10]
hardware/print/stl/front_shell_display.stl
74.1 x 114.0 x 50.3
