Xpitfire/strido/hardware/print/stl/servo_bus_holder_front.stl

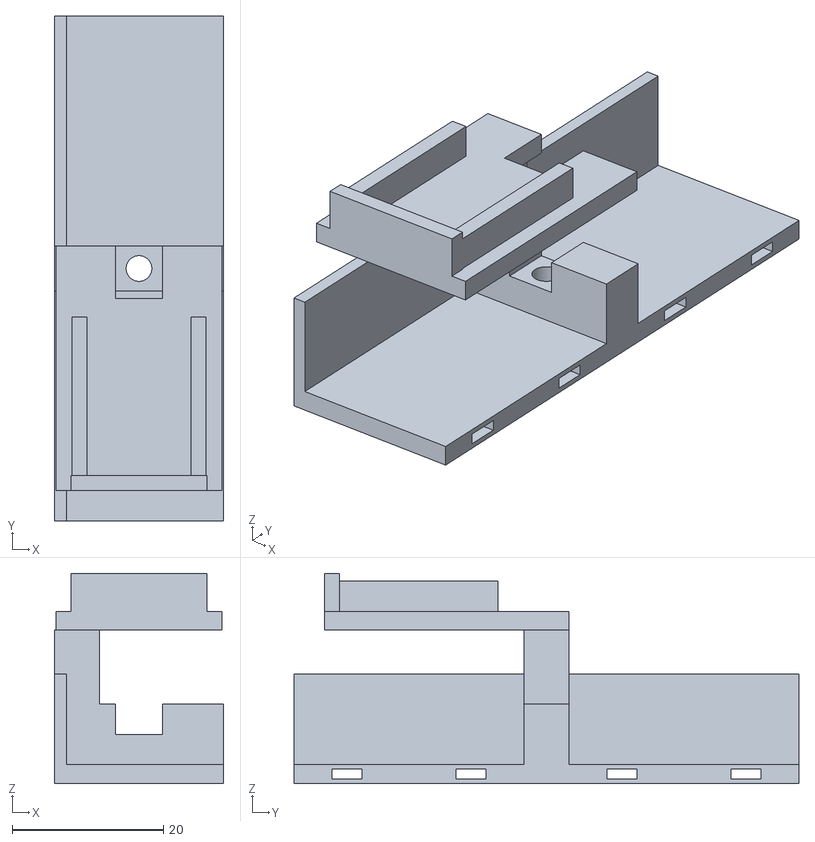
[picture p75: CAD file, 2026-11-10]
hardware/print/stl/servo_bus_holder_front.stl
22.4 x 66.8 x 27.8
