Xpitfire/strido/hardware/print/stl/arming_port_ring.stl

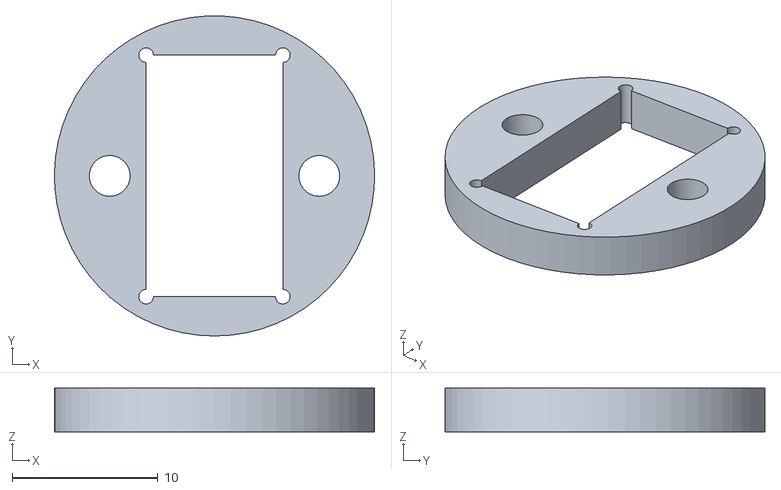
[picture p76: CAD file, 2026-11-10]
hardware/print/stl/arming_port_ring.stl
22.0 x 22.0 x 3.00
