Xpitfire/strido/hardware/print/stl/arming_port_bezel.stl

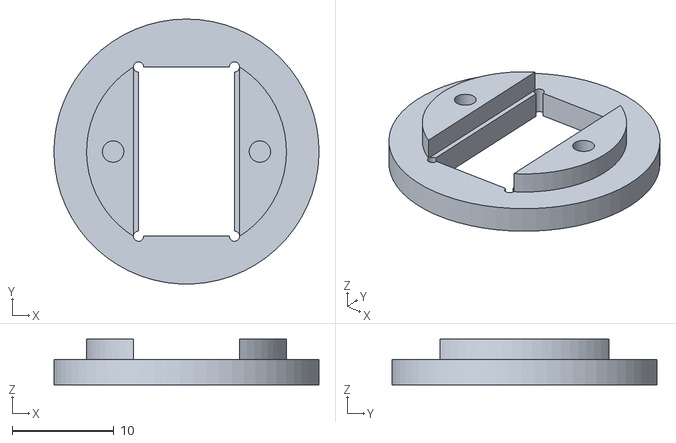
[picture p77: CAD file, 2026-11-10]
hardware/print/stl/arming_port_bezel.stl
26.0 x 26.0 x 4.50
