Xpitfire/strido/(list of files, cad)

Other CAD files:
upstream/yertle/design/STL/Frame/Right_Servo_Mount.stl
upstream/yertle/simulation/meshes/lf_shoulder.obj
upstream/yertle/simulation/meshes/rb_shoulder.obj
upstream/yertle/simulation/meshes/rf_shoulder.obj
hardware/print/plates/plate_graphite_09.3mf
ros2/strido_description/meshes/FL_thigh.stl
upstream/yertle/design/STL/Legs/Right_Shoulder.stl
upstream/yertle/design/STL/Legs/Short_Link.stl
ros2/strido_description/meshes/RR_hip.stl
upstream/yertle/design/STL/Frame/Left_Servo_Mount.stl
hardware/print/stl/left_servo_mount.stl
packages/strido-ntx/src/strido_ntx/robots/models/meshes/FR_calf.stl
ros2/strido_description/meshes/RL_thigh.stl
upstream/yertle/design/STL/Legs/Outer_Tibia.stl
hardware/print/stl/femur.stl
packages/strido-ntx/src/strido_ntx/robots/models/meshes/FR_thigh.stl
ros2/strido_description/meshes/RL_calf.stl
hardware/print/stl/side_body_beam.stl
ros2/strido_description/meshes/FL_hip.stl
hardware/print/plates/plate_graphite_10.3mf
hardware/print/stl/inner_shoulder_frame.stl
ros2/strido_description/meshes/FR_calf.stl
hardware/print/stl/right_servo_mount_fr.stl
packages/strido-ntx/src/strido_ntx/robots/models/meshes/FL_thigh.stl
ros2/strido_description/meshes/FL_calf.stl
hardware/print/stl/femur_servo_connector.stl
packages/strido-ntx/src/strido_ntx/robots/models/meshes/FL_calf.stl
ros2/strido_description/meshes/FR_thigh.stl
hardware/print/stl/outer_tibia.stl
hardware/print/stl/left_servo_mount_fl.stl
hardware/print/stl/right_shoulder.stl
hardware/print/stl/inner_tibia.stl
hardware/print/stl/outer_shoulder_frame.stl
hardware/print/stl/back_shell_button.stl
hardware/print/stl/upper_shoulder_frame.stl
hardware/print/stl/servo_mount_top_bracket.stl
hardware/print/stl/lower_shoulder_frame_rear.stl
hardware/print/stl/bottom_shell.stl
hardware/print/stl/left_shoulder.stl
upstream/yertle/design/CAD/Yertle_Single_v2.stl
