Xpitfire/strido/docs/verification/printability.md

# Printability

Generated by `strido_verify.printability` with PrusaSlicer-2.9.6 based on Slic3r (with GUI support) and `hardware/print/prusaslicer.ini`.

34 part types sliced as oriented in the kit, 13 plates sliced as arranged: **0 fail**, 4 warn. Whole kit: 958 g PETG, 100 h printing (slicer estimate, all pieces).

Thin areas: lateral walls under 0.8 mm (two lines) or horizontal skins under 0.6 mm (three layers); 1 % percentile thickness per orientation.

| Part | Qty | Supports | Brim | Time | Filament (g) | Thin lateral (mm²) | Thin skin (mm²) | Min wall / skin (mm) | Result | Slicer / notes |
|---|---|---|---|---|---|---|---|---|---|---|
| left_servo_mount | 1 | yes | no | 2h 01m | 18.0 | 12 | 22 | 1.54 / 0.42 | warn | thin walls or skins: printable, but only one or two lines / layers thick |
| left_servo_mount_fl | 1 | yes | no | 2h 01m | 18.0 | 7 | 17 | 1.52 / 0.51 | warn | thin walls or skins: printable, but only one or two lines / layers thick |
| right_servo_mount | 1 | yes | no | 2h 01m | 18.0 | 12 | 11 | 1.53 / 0.53 | warn | thin walls or skins: printable, but only one or two lines / layers thick |
| right_servo_mount_fr | 1 | yes | no | 2h 01m | 18.0 | 12 | 26 | 1.52 / 0.38 | warn | thin walls or skins: printable, but only one or two lines / layers thick |
| arming_port_bezel | 1 | no | no | 0h 11m | 1.4 | 0 | 0 | 0.50 / 1.00 | ok |  |
| arming_port_ring | 1 | no | no | 0h 07m | 0.8 | 0 | 0 | 0.96 / 3.00 | ok |  |
| back_shell_button | 1 | no | yes | 4h 33m | 53.0 | 0 | 0 | 1.64 / 2.00 | ok |  |
| bottom_shell | 1 | yes | yes | 8h 12m | 76.2 | 0 | 0 | 1.00 / 1.97 | ok |  |
| camera_mount_base | 1 | no | no | 0h 45m | 5.2 | 0 | 0 | 2.83 / 3.00 | ok |  |
| camera_tilt_plate | 1 | yes | no | 0h 40m | 6.8 | 0 | 0 | 1.10 / 3.00 | ok |  |
| display_bracket | 1 | no | no | 1h 06m | 9.5 | 0 | 0 | 1.82 / 3.00 | ok |  |
| electronics_deck | 1 | yes | no | 5h 11m | 45.3 | 6 | 0 | 1.17 / 1.50 | ok |  |
| femur | 4 | yes | no | 2h 29m | 24.6 | 0 | 0 | 2.36 / 0.73 | ok |  |
| femur_servo_connector | 4 | yes | no | 0h 17m | 2.9 | 0 | 0 | 2.17 / 1.00 | ok |  |
| foot_spacer | 4 | yes | no | 0h 12m | 1.9 | 0 | 0 | 0.83 / 1.16 | ok |  |
| front_shell_display | 1 | no | yes | 3h 40m | 36.7 | 0 | 0 | 1.07 / 1.50 | ok |  |
| hip_bearing_pin | 4 | no | no | 0h 01m | 0.1 | 3 | 0 | 0.58 / 0.65 | ok |  |
| inner_shoulder_frame | 2 | no | no | 2h 01m | 17.7 | 0 | 0 | 0.97 / 2.00 | ok |  |
| inner_tibia | 4 | yes | no | 1h 40m | 16.8 | 0 | 0 | 1.94 / 1.41 | ok |  |
| left_shoulder | 2 | yes | no | 1h 11m | 12.6 | 9 | 0 | 1.04 / 1.50 | ok |  |
| lidar_pedestal | 1 | no | no | 2h 13m | 20.8 | 0 | 0 | 2.79 / 3.00 | ok |  |
| lower_shoulder_frame_front | 1 | no | no | 1h 16m | 11.5 | 0 | 0 | 0.96 / 0.77 | ok |  |
| lower_shoulder_frame_rear | 1 | no | no | 1h 16m | 11.5 | 0 | 0 | 0.96 / 0.77 | ok |  |
| outer_shoulder_frame | 2 | no | no | 2h 19m | 21.8 | 0 | 0 | 3.05 / 0.60 | ok |  |
| outer_tibia | 4 | yes | no | 1h 40m | 16.7 | 0 | 0 | 1.37 / 1.30 | ok |  |
| right_shoulder | 2 | yes | no | 1h 12m | 12.5 | 0 | 0 | 1.06 / 1.50 | ok |  |
| servo_bus_holder_front | 1 | yes | no | 1h 13m | 11.4 | 0 | 0 | 1.60 / 0.60 | ok |  |
| servo_bus_holder_rear | 1 | yes | no | 0h 45m | 6.8 | 0 | 0 | 1.54 / 0.60 | ok | supports listed, but the slicer finds nothing to support |
| servo_mount_top_bracket | 4 | no | no | 0h 26m | 4.2 | 0 | 0 | 2.53 / 1.33 | ok |  |
| short_link | 4 | yes | no | 0h 13m | 1.9 | 0 | 0 | 0.57 / 0.56 | ok |  |
| side_body_beam | 2 | no | no | 1h 33m | 14.2 | 0 | 0 | 2.10 / 1.03 | ok |  |
| stiff_long_link | 4 | no | no | 0h 58m | 10.8 | 0 | 0 | 1.00 / 10.00 | ok |  |
| top_shell_sensor | 1 | yes | yes | 8h 37m | 77.2 | 0 | 0 | 1.00 / 1.97 | ok |  |
| upper_shoulder_frame | 2 | no | no | 1h 50m | 17.9 | 0 | 0 | 1.40 / 0.95 | ok |  |

| Plate | Result | Slicer |
|---|---|---|
| plate_graphite_01.3mf | ok |  |
| plate_graphite_02.3mf | ok |  |
| plate_graphite_03.3mf | ok |  |
| plate_graphite_04.3mf | ok |  |
| plate_graphite_05.3mf | ok |  |
| plate_graphite_06.3mf | ok |  |
| plate_graphite_07.3mf | ok |  |
| plate_graphite_08.3mf | ok |  |
| plate_graphite_09.3mf | ok |  |
| plate_graphite_10.3mf | ok |  |
| plate_lime_01.3mf | ok |  |
| plate_lime_02.3mf | ok |  |
| plate_lime_03.3mf | ok |  |
