Xpitfire/strido/assistant/test/fixtures/content/docs/verification/wiring.md

# Wiring check

## Summary

Every lead reaches.
