Xpitfire/strido/docs/verification/fits.md

# Fits and tolerances

Generated by `strido_verify.fits` from the assembled CAD (reference pose) and `hardware/verification/tolerances.yaml`. Every screw axis is sampled every 0.5 mm; each printed part around it is cut normal to the axis and its narrowest hole diameter classified.

**Screws:** 223 — ok 86, warn 137, **fail 0**. **Bearing seats:** 32 — fail 0.

| Fit class | ok | warn | fail |
|---|---|---|---|
| clearance | 69 | 80 | 0 |
| thread-forming | 19 | 67 | 0 |
| tight passage | 0 | 58 | 0 |
| passage | 37 | 0 | 0 |
| bearing bore | 31 | 0 | 0 |
| line-to-line | 0 | 0 | 0 |
| solid | 0 | 0 | 0 |
| oversize | 0 | 0 | 0 |

| Screw termination | Count |
|---|---|
| nut | 105 |
| thread-forming | 78 |
| vendor thread | 40 |

## Warnings: what to do after printing

Printed holes come out ~0.15 mm undersize. *Clearance / tight passage*: run the ISO 273 drill through once. *Thread-forming, weak grip*: tighten by feel; if a screw spins, harden the pilot with a drop of thin CA glue and re-drive (anaerobic thread locker does not cure on plastic and can crack PETG). *Short engagement*: do not over-tighten.

| Part | Fit | Thread | CAD hole (mm) | Holes | Action |
|---|---|---|---|---|---|
| arming_port_bezel | thread-forming | M2.5 | 2.10 | 2 | short engagement 2.5 mm (< 1.5 d) |
| back_shell_button | tight passage | M3 | 2.94 | 1 | drill 3.2 mm (or 3.4 mm) |
| back_shell_button | tight passage | M3 | 2.95 | 1 | drill 3.2 mm (or 3.4 mm) |
| back_shell_button | tight passage | M3 | 2.98 | 1 | drill 3.2 mm (or 3.4 mm) |
| back_shell_button | tight passage | M3 | 3.02 | 1 | drill 3.2 mm (or 3.4 mm) |
| bottom_shell | clearance | M3 | 3.05 | 4 | drill 3.2 mm (or 3.4 mm) |
| camera_tilt_plate | clearance | M2 | 2.20 | 4 | drill 2.2 mm (or 2.4 mm) |
| electronics_deck | clearance | M2.5 | 2.69 | 1 | drill 2.7 mm (or 2.9 mm) |
| electronics_deck | clearance | M2.5 | 2.69 | 1 | drill 2.7 mm (or 2.9 mm) |
| femur | thread-forming | M3 | 2.80 | 2 | short engagement 4.0 mm (< 1.5 d) |
| femur | thread-forming | M3 | 2.85 | 1 | short engagement 4.0 mm (< 1.5 d) |
| femur | thread-forming | M3 | 2.85 | 1 | short engagement 4.0 mm (< 1.5 d) |
| femur | thread-forming | M3 | 2.85 | 1 | short engagement 4.0 mm (< 1.5 d) |
| front_shell_display | clearance | M3 | 3.08 | 1 | drill 3.2 mm (or 3.4 mm) |
| front_shell_display | clearance | M3 | 3.08 | 1 | drill 3.2 mm (or 3.4 mm) |
| front_shell_display | tight passage | M3 | 2.96 | 1 | drill 3.2 mm (or 3.4 mm) |
| front_shell_display | tight passage | M3 | 2.97 | 1 | drill 3.2 mm (or 3.4 mm) |
| inner_shoulder_frame | clearance | M3 | 3.07 | 1 | drill 3.2 mm (or 3.4 mm) |
| inner_shoulder_frame | clearance | M3 | 3.08 | 1 | drill 3.2 mm (or 3.4 mm) |
| inner_shoulder_frame | clearance | M3 | 3.10 | 2 | drill 3.2 mm (or 3.4 mm) |
| inner_shoulder_frame | clearance | M3 | 3.11 | 2 | drill 3.2 mm (or 3.4 mm) |
| inner_shoulder_frame | clearance | M3 | 3.12 | 2 | drill 3.2 mm (or 3.4 mm) |
| inner_shoulder_frame | clearance | M3 | 3.13 | 1 | drill 3.2 mm (or 3.4 mm) |
| inner_shoulder_frame | clearance | M3 | 3.15 | 1 | drill 3.2 mm (or 3.4 mm) |
| inner_shoulder_frame | clearance | M3 | 3.15 | 2 | drill 3.2 mm (or 3.4 mm) |
| inner_shoulder_frame | tight passage | M3 | 2.58 | 1 | drill 3.2 mm (or 3.4 mm) |
| inner_shoulder_frame | tight passage | M3 | 2.58 | 1 | drill 3.2 mm (or 3.4 mm) |
| inner_shoulder_frame | tight passage | M3 | 2.69 | 1 | drill 3.2 mm (or 3.4 mm) |
| inner_shoulder_frame | tight passage | M3 | 2.69 | 1 | drill 3.2 mm (or 3.4 mm) |
| inner_shoulder_frame | tight passage | M3 | 2.87 | 2 | drill 3.2 mm (or 3.4 mm) |
| inner_shoulder_frame | tight passage | M3 | 2.88 | 2 | drill 3.2 mm (or 3.4 mm) |
| inner_shoulder_frame | tight passage | M3 | 2.89 | 2 | drill 3.2 mm (or 3.4 mm) |
| inner_shoulder_frame | tight passage | M3 | 2.90 | 2 | drill 3.2 mm (or 3.4 mm) |
| inner_shoulder_frame | tight passage | M3 | 2.92 | 4 | drill 3.2 mm (or 3.4 mm) |
| inner_shoulder_frame | tight passage | M3 | 2.96 | 2 | drill 3.2 mm (or 3.4 mm) |
| inner_shoulder_frame | tight passage | M3 | 2.97 | 2 | drill 3.2 mm (or 3.4 mm) |
| inner_tibia | clearance | M3 | 3.09 | 1 | drill 3.2 mm (or 3.4 mm) |
| inner_tibia | clearance | M3 | 3.10 | 1 | drill 3.2 mm (or 3.4 mm) |
| inner_tibia | clearance | M3 | 3.12 | 1 | drill 3.2 mm (or 3.4 mm) |
| inner_tibia | clearance | M3 | 3.13 | 1 | drill 3.2 mm (or 3.4 mm) |
| inner_tibia | tight passage | M3 | 2.90 | 1 | drill 3.2 mm (or 3.4 mm) |
| inner_tibia | tight passage | M3 | 2.90 | 1 | drill 3.2 mm (or 3.4 mm) |
| inner_tibia | tight passage | M3 | 2.90 | 1 | drill 3.2 mm (or 3.4 mm) |
| inner_tibia | tight passage | M3 | 2.91 | 1 | drill 3.2 mm (or 3.4 mm) |
| inner_tibia | tight passage | M3 | 2.92 | 1 | drill 3.2 mm (or 3.4 mm) |
| inner_tibia | tight passage | M3 | 2.93 | 1 | drill 3.2 mm (or 3.4 mm) |
| inner_tibia | tight passage | M3 | 2.93 | 1 | drill 3.2 mm (or 3.4 mm) |
| inner_tibia | tight passage | M3 | 2.94 | 1 | drill 3.2 mm (or 3.4 mm) |
| inner_tibia | tight passage | M3 | 2.94 | 1 | drill 3.2 mm (or 3.4 mm) |
| inner_tibia | tight passage | M3 | 2.94 | 1 | drill 3.2 mm (or 3.4 mm) |
| inner_tibia | tight passage | M3 | 2.94 | 1 | drill 3.2 mm (or 3.4 mm) |
| inner_tibia | tight passage | M3 | 2.95 | 1 | drill 3.2 mm (or 3.4 mm) |
| left_servo_mount | thread-forming | M3 | 2.92 | 1 | weak grip (printed ratio 0.92): stop when snug; if it spins, harden the pilot with thin CA glue and re-drive (no anaerobic thread locker on plastic) |
| left_servo_mount | thread-forming | M3 | 2.92 | 1 | weak grip (printed ratio 0.92): stop when snug; if it spins, harden the pilot with thin CA glue and re-drive (no anaerobic thread locker on plastic) |
| left_servo_mount | thread-forming | M3 | 2.92 | 1 | weak grip (printed ratio 0.93): stop when snug; if it spins, harden the pilot with thin CA glue and re-drive (no anaerobic thread locker on plastic) |
| left_servo_mount | thread-forming | M3 | 2.93 | 1 | weak grip (printed ratio 0.93): stop when snug; if it spins, harden the pilot with thin CA glue and re-drive (no anaerobic thread locker on plastic) |
| left_servo_mount | thread-forming | M3 | 2.94 | 1 | accepted deviation (ADR-009): print with X-Y hole compensation -0.15 mm (pilot ~2.65 mm); on an uncompensated print, harden the pilot with a drop of thin CA glue before driving the screw and check it bites before loading the joint (no anaerobic thread locker on plastic) |
| left_servo_mount | thread-forming | M3 | 2.94 | 1 | accepted deviation (ADR-009): print with X-Y hole compensation -0.15 mm (pilot ~2.65 mm); on an uncompensated print, harden the pilot with a drop of thin CA glue before driving the screw and check it bites before loading the joint (no anaerobic thread locker on plastic) |
| left_servo_mount | thread-forming | M3 | 2.94 | 2 | accepted deviation (ADR-009): print with X-Y hole compensation -0.15 mm (pilot ~2.65 mm); on an uncompensated print, harden the pilot with a drop of thin CA glue before driving the screw and check it bites before loading the joint (no anaerobic thread locker on plastic) |
| left_servo_mount | thread-forming | M3 | 2.94 | 1 | accepted deviation (ADR-009): print with X-Y hole compensation -0.15 mm (pilot ~2.65 mm); on an uncompensated print, harden the pilot with a drop of thin CA glue before driving the screw and check it bites before loading the joint (no anaerobic thread locker on plastic) |
| left_servo_mount | thread-forming | M3 | 2.95 | 1 | accepted deviation (ADR-009): print with X-Y hole compensation -0.15 mm (pilot ~2.65 mm); on an uncompensated print, harden the pilot with a drop of thin CA glue before driving the screw and check it bites before loading the joint (no anaerobic thread locker on plastic) |
| left_servo_mount | thread-forming | M3 | 2.95 | 1 | accepted deviation (ADR-009): print with X-Y hole compensation -0.15 mm (pilot ~2.65 mm); on an uncompensated print, harden the pilot with a drop of thin CA glue before driving the screw and check it bites before loading the joint (no anaerobic thread locker on plastic) |
| left_servo_mount | thread-forming | M3 | 2.96 | 1 | accepted deviation (ADR-009): print with X-Y hole compensation -0.15 mm (pilot ~2.65 mm); on an uncompensated print, harden the pilot with a drop of thin CA glue before driving the screw and check it bites before loading the joint (no anaerobic thread locker on plastic) |
| left_servo_mount | thread-forming | M3 | 2.96 | 1 | accepted deviation (ADR-009): print with X-Y hole compensation -0.15 mm (pilot ~2.65 mm); on an uncompensated print, harden the pilot with a drop of thin CA glue before driving the screw and check it bites before loading the joint (no anaerobic thread locker on plastic) |
| left_servo_mount_fl | thread-forming | M3 | 2.50 | 1 | short engagement 4.0 mm (< 1.5 d) |
| left_servo_mount_fl | thread-forming | M3 | 2.88 | 1 | weak grip (printed ratio 0.91): stop when snug; if it spins, harden the pilot with thin CA glue and re-drive (no anaerobic thread locker on plastic) |
| left_servo_mount_fl | thread-forming | M3 | 2.89 | 1 | weak grip (printed ratio 0.91): stop when snug; if it spins, harden the pilot with thin CA glue and re-drive (no anaerobic thread locker on plastic) |
| left_servo_mount_fl | thread-forming | M3 | 2.90 | 3 | weak grip (printed ratio 0.92): stop when snug; if it spins, harden the pilot with thin CA glue and re-drive (no anaerobic thread locker on plastic) |
| left_servo_mount_fl | thread-forming | M3 | 2.90 | 1 | weak grip (printed ratio 0.92): stop when snug; if it spins, harden the pilot with thin CA glue and re-drive (no anaerobic thread locker on plastic) |
| left_servo_mount_fl | thread-forming | M3 | 2.91 | 1 | weak grip (printed ratio 0.92): stop when snug; if it spins, harden the pilot with thin CA glue and re-drive (no anaerobic thread locker on plastic) |
| left_servo_mount_fl | thread-forming | M3 | 2.91 | 1 | weak grip (printed ratio 0.92): stop when snug; if it spins, harden the pilot with thin CA glue and re-drive (no anaerobic thread locker on plastic) |
| left_servo_mount_fl | thread-forming | M3 | 2.92 | 1 | weak grip (printed ratio 0.92): stop when snug; if it spins, harden the pilot with thin CA glue and re-drive (no anaerobic thread locker on plastic) |
| left_servo_mount_fl | thread-forming | M3 | 2.93 | 1 | weak grip (printed ratio 0.93): stop when snug; if it spins, harden the pilot with thin CA glue and re-drive (no anaerobic thread locker on plastic) |
| left_servo_mount_fl | thread-forming | M3 | 2.94 | 1 | accepted deviation (ADR-009): print with X-Y hole compensation -0.15 mm (pilot ~2.65 mm); on an uncompensated print, harden the pilot with a drop of thin CA glue before driving the screw and check it bites before loading the joint (no anaerobic thread locker on plastic) |
| left_servo_mount_fl | thread-forming | M3 | 2.95 | 1 | accepted deviation (ADR-009): print with X-Y hole compensation -0.15 mm (pilot ~2.65 mm); on an uncompensated print, harden the pilot with a drop of thin CA glue before driving the screw and check it bites before loading the joint (no anaerobic thread locker on plastic) |
| lower_shoulder_frame_front | clearance | M3 | 3.13 | 1 | drill 3.2 mm (or 3.4 mm) |
| lower_shoulder_frame_front | clearance | M3 | 3.13 | 1 | drill 3.2 mm (or 3.4 mm) |
| lower_shoulder_frame_front | clearance | M3 | 3.15 | 2 | drill 3.2 mm (or 3.4 mm) |
| lower_shoulder_frame_front | clearance | M3 | 3.15 | 1 | drill 3.2 mm (or 3.4 mm) |
| lower_shoulder_frame_front | clearance | M3 | 3.15 | 1 | drill 3.2 mm (or 3.4 mm) |
| lower_shoulder_frame_front | clearance | M3 | 3.15 | 1 | drill 3.2 mm (or 3.4 mm) |
| lower_shoulder_frame_front | clearance | M3 | 3.17 | 1 | drill 3.2 mm (or 3.4 mm) |
| lower_shoulder_frame_rear | clearance | M3 | 3.15 | 1 | drill 3.2 mm (or 3.4 mm) |
| lower_shoulder_frame_rear | clearance | M3 | 3.15 | 1 | drill 3.2 mm (or 3.4 mm) |
| lower_shoulder_frame_rear | clearance | M3 | 3.15 | 1 | drill 3.2 mm (or 3.4 mm) |
| lower_shoulder_frame_rear | clearance | M3 | 3.15 | 1 | drill 3.2 mm (or 3.4 mm) |
| lower_shoulder_frame_rear | clearance | M3 | 3.16 | 1 | drill 3.2 mm (or 3.4 mm) |
| lower_shoulder_frame_rear | clearance | M3 | 3.17 | 1 | drill 3.2 mm (or 3.4 mm) |
| lower_shoulder_frame_rear | clearance | M3 | 3.17 | 1 | drill 3.2 mm (or 3.4 mm) |
| lower_shoulder_frame_rear | clearance | M3 | 3.17 | 1 | drill 3.2 mm (or 3.4 mm) |
| outer_shoulder_frame | clearance | M3 | 3.10 | 1 | drill 3.2 mm (or 3.4 mm) |
| outer_shoulder_frame | clearance | M3 | 3.10 | 1 | drill 3.2 mm (or 3.4 mm) |
| outer_shoulder_frame | clearance | M3 | 3.10 | 1 | drill 3.2 mm (or 3.4 mm) |
| outer_shoulder_frame | clearance | M3 | 3.10 | 2 | drill 3.2 mm (or 3.4 mm) |
| outer_shoulder_frame | clearance | M3 | 3.11 | 1 | drill 3.2 mm (or 3.4 mm) |
| outer_shoulder_frame | clearance | M3 | 3.11 | 1 | drill 3.2 mm (or 3.4 mm) |
| outer_shoulder_frame | clearance | M3 | 3.12 | 1 | drill 3.2 mm (or 3.4 mm) |
| outer_tibia | clearance | M3 | 3.09 | 1 | drill 3.2 mm (or 3.4 mm) |
| outer_tibia | clearance | M3 | 3.11 | 1 | drill 3.2 mm (or 3.4 mm) |
| outer_tibia | clearance | M3 | 3.12 | 2 | drill 3.2 mm (or 3.4 mm) |
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
| right_servo_mount_fr | thread-forming | M3 | 2.50 | 1 | short engagement 4.0 mm (< 1.5 d) |
| right_servo_mount_fr | thread-forming | M3 | 2.92 | 2 | weak grip (printed ratio 0.92): stop when snug; if it spins, harden the pilot with thin CA glue and re-drive (no anaerobic thread locker on plastic) |
| right_servo_mount_fr | thread-forming | M3 | 2.93 | 1 | weak grip (printed ratio 0.93): stop when snug; if it spins, harden the pilot with thin CA glue and re-drive (no anaerobic thread locker on plastic) |
| right_servo_mount_fr | thread-forming | M3 | 2.93 | 1 | weak grip (printed ratio 0.93): stop when snug; if it spins, harden the pilot with thin CA glue and re-drive (no anaerobic thread locker on plastic) |
| right_servo_mount_fr | thread-forming | M3 | 2.94 | 1 | weak grip (printed ratio 0.93): stop when snug; if it spins, harden the pilot with thin CA glue and re-drive (no anaerobic thread locker on plastic) |
| right_servo_mount_fr | thread-forming | M3 | 2.94 | 2 | weak grip (printed ratio 0.93): stop when snug; if it spins, harden the pilot with thin CA glue and re-drive (no anaerobic thread locker on plastic) |
| right_servo_mount_fr | thread-forming | M3 | 2.94 | 1 | accepted deviation (ADR-009): print with X-Y hole compensation -0.15 mm (pilot ~2.65 mm); on an uncompensated print, harden the pilot with a drop of thin CA glue before driving the screw and check it bites before loading the joint (no anaerobic thread locker on plastic) |
| right_servo_mount_fr | thread-forming | M3 | 2.94 | 2 | accepted deviation (ADR-009): print with X-Y hole compensation -0.15 mm (pilot ~2.65 mm); on an uncompensated print, harden the pilot with a drop of thin CA glue before driving the screw and check it bites before loading the joint (no anaerobic thread locker on plastic) |
| right_servo_mount_fr | thread-forming | M3 | 2.94 | 2 | accepted deviation (ADR-009): print with X-Y hole compensation -0.15 mm (pilot ~2.65 mm); on an uncompensated print, harden the pilot with a drop of thin CA glue before driving the screw and check it bites before loading the joint (no anaerobic thread locker on plastic) |
| servo_mount_top_bracket | thread-forming | M3 | 2.93 | 2 | weak grip (printed ratio 0.93): stop when snug; if it spins, harden the pilot with thin CA glue and re-drive (no anaerobic thread locker on plastic) |
| servo_mount_top_bracket | thread-forming | M3 | 2.94 | 1 | weak grip (printed ratio 0.93): stop when snug; if it spins, harden the pilot with thin CA glue and re-drive (no anaerobic thread locker on plastic) |
| servo_mount_top_bracket | thread-forming | M3 | 2.94 | 1 | weak grip (printed ratio 0.93): stop when snug; if it spins, harden the pilot with thin CA glue and re-drive (no anaerobic thread locker on plastic) |
| servo_mount_top_bracket | thread-forming | M3 | 2.96 | 1 | accepted deviation (ADR-009): print with X-Y hole compensation -0.15 mm (pilot ~2.65 mm); on an uncompensated print, harden the pilot with a drop of thin CA glue before driving the screw and check it bites before loading the joint (no anaerobic thread locker on plastic) |
| servo_mount_top_bracket | thread-forming | M3 | 2.96 | 1 | accepted deviation (ADR-009): print with X-Y hole compensation -0.15 mm (pilot ~2.65 mm); on an uncompensated print, harden the pilot with a drop of thin CA glue before driving the screw and check it bites before loading the joint (no anaerobic thread locker on plastic) |
| servo_mount_top_bracket | thread-forming | M3 | 2.97 | 1 | accepted deviation (ADR-009): print with X-Y hole compensation -0.15 mm (pilot ~2.65 mm); on an uncompensated print, harden the pilot with a drop of thin CA glue before driving the screw and check it bites before loading the joint (no anaerobic thread locker on plastic) |
| servo_mount_top_bracket | thread-forming | M3 | 2.97 | 1 | accepted deviation (ADR-009): print with X-Y hole compensation -0.15 mm (pilot ~2.65 mm); on an uncompensated print, harden the pilot with a drop of thin CA glue before driving the screw and check it bites before loading the joint (no anaerobic thread locker on plastic) |
| side_body_beam | clearance | M3 | 3.13 | 2 | drill 3.2 mm (or 3.4 mm) |
| side_body_beam | clearance | M3 | 3.13 | 2 | drill 3.2 mm (or 3.4 mm) |
| side_body_beam | clearance | M3 | 3.16 | 2 | drill 3.2 mm (or 3.4 mm) |
| side_body_beam | clearance | M3 | 3.16 | 2 | drill 3.2 mm (or 3.4 mm) |
| stiff_long_link | tight passage | M3 | 2.91 | 1 | drill 3.2 mm (or 3.4 mm) |
| stiff_long_link | tight passage | M3 | 2.91 | 1 | drill 3.2 mm (or 3.4 mm) |
| stiff_long_link | tight passage | M3 | 3.02 | 1 | drill 3.2 mm (or 3.4 mm) |
| stiff_long_link | tight passage | M3 | 3.03 | 1 | drill 3.2 mm (or 3.4 mm) |
| top_shell_sensor | tight passage | M3 | 2.36 | 1 | drill 3.2 mm (or 3.4 mm) |
| top_shell_sensor | tight passage | M3 | 2.37 | 1 | drill 3.2 mm (or 3.4 mm) |
| top_shell_sensor | tight passage | M3 | 2.38 | 1 | drill 3.2 mm (or 3.4 mm) |
| top_shell_sensor | tight passage | M3 | 2.38 | 1 | drill 3.2 mm (or 3.4 mm) |
| upper_shoulder_frame | clearance | M3 | 3.08 | 2 | drill 3.2 mm (or 3.4 mm) |
| upper_shoulder_frame | clearance | M3 | 3.12 | 2 | drill 3.2 mm (or 3.4 mm) |
| upper_shoulder_frame | clearance | M3 | 3.13 | 1 | drill 3.2 mm (or 3.4 mm) |
| upper_shoulder_frame | clearance | M3 | 3.14 | 1 | drill 3.2 mm (or 3.4 mm) |
| upper_shoulder_frame | clearance | M3 | 3.14 | 1 | drill 3.2 mm (or 3.4 mm) |
| upper_shoulder_frame | clearance | M3 | 3.14 | 1 | drill 3.2 mm (or 3.4 mm) |
| upper_shoulder_frame | clearance | M3 | 3.14 | 2 | drill 3.2 mm (or 3.4 mm) |
| upper_shoulder_frame | clearance | M3 | 3.15 | 1 | drill 3.2 mm (or 3.4 mm) |
| upper_shoulder_frame | clearance | M3 | 3.15 | 1 | drill 3.2 mm (or 3.4 mm) |
| upper_shoulder_frame | clearance | M3 | 3.16 | 2 | drill 3.2 mm (or 3.4 mm) |
| upper_shoulder_frame | clearance | M3 | 3.16 | 1 | drill 3.2 mm (or 3.4 mm) |
| upper_shoulder_frame | clearance | M3 | 3.16 | 1 | drill 3.2 mm (or 3.4 mm) |

## Failures

None.

## Bearing seats

| Bearing | Part | OD (mm) | Seat (mm) | Result |
|---|---|---|---|---|
| body/bearing_625zz@0147 | outer_shoulder_frame | 16.0 | 16.213 | ok |
| body/bearing_625zz@0148 | outer_shoulder_frame | 16.0 | 16.166 | ok |
| body/bearing_625zz@0150 | outer_shoulder_frame | 16.0 | 16.191 | ok |
| body/bearing_625zz@0151 | outer_shoulder_frame | 16.0 | 16.195 | ok |
| RL/sleeve_bearing_3x5x5_pair@0159 | short_link | 5.0 | 4.986 | ok |
| RL/sleeve_bearing_3x5x5_pair@0160 | short_link | 5.0 | 4.977 | ok |
| RL/sleeve_bearing_3x5x5_pair@0177 | stiff_long_link | 5.0 | 4.948 | ok |
| RL/sleeve_bearing_3x5x5_pair@0178 | stiff_long_link | 5.0 | 4.861 | ok |
| RL/bearing_6805_2rs@0179 | left_shoulder | 37.0 | 36.933 | ok |
| RL/bearing_633zz@0203 | outer_tibia | 13.0 | 13.226 | ok |
| RL/bearing_633zz@0204 | inner_tibia | 13.0 | 13.208 | ok |
| FL/sleeve_bearing_3x5x5_pair@0218 | short_link | 5.0 | 4.983 | ok |
| FL/sleeve_bearing_3x5x5_pair@0219 | short_link | 5.0 | 4.979 | ok |
| FL/sleeve_bearing_3x5x5_pair@0236 | stiff_long_link | 5.0 | 4.948 | ok |
| FL/sleeve_bearing_3x5x5_pair@0237 | stiff_long_link | 5.0 | 4.863 | ok |
| FL/bearing_6805_2rs@0238 | left_shoulder | 37.0 | 36.921 | ok |
| FL/bearing_633zz@0262 | inner_tibia | 13.0 | 13.226 | ok |
| FL/bearing_633zz@0263 | outer_tibia | 13.0 | 13.227 | ok |
| RR/sleeve_bearing_3x5x5_pair@0276 | short_link | 5.0 | 4.983 | ok |
| RR/sleeve_bearing_3x5x5_pair@0277 | short_link | 5.0 | 4.983 | ok |
| RR/sleeve_bearing_3x5x5_pair@0294 | stiff_long_link | 5.0 | 4.927 | ok |
| RR/sleeve_bearing_3x5x5_pair@0295 | stiff_long_link | 5.0 | 4.853 | ok |
| RR/bearing_6805_2rs@0296 | right_shoulder | 37.0 | 36.945 | ok |
| RR/bearing_633zz@0320 | outer_tibia | 13.0 | 13.186 | ok |
| RR/bearing_633zz@0321 | inner_tibia | 13.0 | 13.233 | ok |
| FR/sleeve_bearing_3x5x5_pair@0335 | short_link | 5.0 | 4.984 | ok |
| FR/sleeve_bearing_3x5x5_pair@0336 | short_link | 5.0 | 4.983 | ok |
| FR/sleeve_bearing_3x5x5_pair@0353 | stiff_long_link | 5.0 | 4.925 | ok |
| FR/sleeve_bearing_3x5x5_pair@0354 | stiff_long_link | 5.0 | 4.856 | ok |
| FR/bearing_6805_2rs@0355 | right_shoulder | 37.0 | 36.94 | ok |
| FR/bearing_633zz@0379 | outer_tibia | 13.0 | 13.207 | ok |
| FR/bearing_633zz@0380 | inner_tibia | 13.0 | 13.176 | ok |
