Xpitfire/strido/assistant/test/fixtures/content/docs/wiki/index.md

# Learn

The wiki explains the engineering.

## Hardware

Servos, power and buses.
