Xpitfire/strido/models/mujoco/strido.xml

<mujoco model="strido">
  <!-- GENERATED by strido_cad.models - do not edit. -->
  <compiler angle="radian" meshdir="../../ros2/strido_description/meshes" autolimits="true"/>
  <option timestep="0.002" integrator="implicitfast"/>
  <default>
    <default class="servo">
      <joint damping="0.25" armature="0.012" frictionloss="0.05"/>
      <position kp="25" kv="0.4" forcerange="-3.432 3.432" inheritrange="1"/>
    </default>
    <default class="visual"><geom contype="0" conaffinity="0" group="2"/></default>
    <default class="collision"><geom group="3" friction="0.9 0.02 0.001"/></default>
  </default>
  <asset>
    <mesh name="base_link" file="base_link.stl"/>
    <mesh name="FL_hip" file="FL_hip.stl"/>
    <mesh name="FL_thigh" file="FL_thigh.stl"/>
    <mesh name="FL_calf" file="FL_calf.stl"/>
    <mesh name="FR_hip" file="FR_hip.stl"/>
    <mesh name="FR_thigh" file="FR_thigh.stl"/>
    <mesh name="FR_calf" file="FR_calf.stl"/>
    <mesh name="RL_hip" file="RL_hip.stl"/>
    <mesh name="RL_thigh" file="RL_thigh.stl"/>
    <mesh name="RL_calf" file="RL_calf.stl"/>
    <mesh name="RR_hip" file="RR_hip.stl"/>
    <mesh name="RR_thigh" file="RR_thigh.stl"/>
    <mesh name="RR_calf" file="RR_calf.stl"/>
  </asset>
  <worldbody>
    <body name="base_link" pos="0 0 0.200" childclass="servo">
      <freejoint name="root"/>
      <inertial pos="0.00533714 0.000164431 -0.00651363" mass="1.70851" fullinertia="0.00261131 0.0137536 0.0137853 -8.21703e-07 0.000164474 1.70834e-05"/>
      <geom class="visual" type="mesh" mesh="base_link" rgba="0.78 0.88 0.12 1"/>
      <geom class="collision" type="box" pos="-0.000461314 1.9001e-05 0.000601007" size="0.187046 0.0570481 0.0497853"/>
      <site name="imu" pos="0.041953 -0.0043 -0.0110833"/>
      <site name="lidar" pos="-0.034157 0 0.0716167"/>
      <body name="FL_hip" pos="0.119673 0.039 0">
        <inertial pos="0.0082456 0.00976004 -0.00566959" mass="0.238911" fullinertia="7.15816e-05 6.67418e-05 6.32592e-05 4.56068e-06 6.63265e-06 -1.5388e-05"/>
        <joint name="FL_hip_joint" axis="1 0 0" range="-0.3054 0.8727"/>
        <geom class="visual" type="mesh" mesh="FL_hip" rgba="0.18 0.18 0.19 1"/>
        <body name="FL_thigh" pos="0 0.0382569 0">
          <inertial pos="-0.0082624 -0.00171585 -0.0468724" mass="0.0505958" fullinertia="0.000106437 0.000114145 1.04389e-05 1.40387e-07 -7.12122e-06 2.68886e-06"/>
          <joint name="FL_thigh_joint" axis="0 1 0" range="-0.6981 2.1817"/>
          <geom class="visual" type="mesh" mesh="FL_thigh" rgba="0.18 0.18 0.19 1"/>
          <geom class="collision" type="capsule" fromto="0 0 -0.02 0 0 -0.1100" size="0.011"/>
          <body name="FL_calf" pos="0 0 -0.129999">
            <inertial pos="0.00157276 -0.00024066 -0.0483311" mass="0.0520587" fullinertia="0.000149829 0.000148958 4.84964e-06 2.85251e-08 4.86832e-06 -1.27588e-07"/>
            <joint name="FL_calf_joint" axis="0 1 0" range="-2.6180 -0.7854"/>
            <geom class="visual" type="mesh" mesh="FL_calf" rgba="0.18 0.18 0.19 1"/>
            <geom class="collision" type="capsule" fromto="0 0 -0.02 0 0 -0.1041" size="0.009"/>
            <geom name="FL_foot" class="collision" type="sphere" pos="0 0 -0.124062" size="0.01198" friction="1.0 0.02 0.001"/>
            <site name="FL_foot" pos="0 0 -0.124062"/>
            <body name="FL_foot" pos="0 0 -0.124062"/>
          </body>
        </body>
      </body>
      <body name="FR_hip" pos="0.119673 -0.039 0">
        <inertial pos="0.00824655 -0.00975914 -0.00566936" mass="0.238911" fullinertia="7.15862e-05 6.67299e-05 6.32633e-05 -4.55375e-06 6.62781e-06 1.53861e-05"/>
        <joint name="FR_hip_joint" axis="1 0 0" range="-0.8727 0.3054"/>
        <geom class="visual" type="mesh" mesh="FR_hip" rgba="0.18 0.18 0.19 1"/>
        <body name="FR_thigh" pos="0 -0.0382569 0">
          <inertial pos="-0.00825812 0.00172085 -0.0468808" mass="0.0505958" fullinertia="0.00010642 0.000114131 1.04414e-05 -1.40979e-07 -7.10351e-06 -2.67864e-06"/>
          <joint name="FR_thigh_joint" axis="0 1 0" range="-0.6981 2.1817"/>
          <geom class="visual" type="mesh" mesh="FR_thigh" rgba="0.18 0.18 0.19 1"/>
          <geom class="collision" type="capsule" fromto="0 0 -0.02 0 0 -0.1100" size="0.011"/>
          <body name="FR_calf" pos="0 0 -0.129999">
            <inertial pos="0.00157633 0.000227239 -0.0483187" mass="0.0520587" fullinertia="0.000149816 0.000148944 4.85095e-06 -2.51644e-08 4.8755e-06 9.5213e-08"/>
            <joint name="FR_calf_joint" axis="0 1 0" range="-2.6180 -0.7854"/>
            <geom class="visual" type="mesh" mesh="FR_calf" rgba="0.18 0.18 0.19 1"/>
            <geom class="collision" type="capsule" fromto="0 0 -0.02 0 0 -0.1041" size="0.009"/>
            <geom name="FR_foot" class="collision" type="sphere" pos="0 0 -0.124062" size="0.01198" friction="1.0 0.02 0.001"/>
            <site name="FR_foot" pos="0 0 -0.124062"/>
            <body name="FR_foot" pos="0 0 -0.124062"/>
          </body>
        </body>
      </body>
      <body name="RL_hip" pos="-0.119673 0.039 -0">
        <inertial pos="0.00918348 0.0114594 -0.00569306" mass="0.238587" fullinertia="7.25942e-05 6.70418e-05 6.4687e-05 7.1069e-06 5.32866e-06 -1.54201e-05"/>
        <joint name="RL_hip_joint" axis="1 0 0" range="-0.3054 0.7854"/>
        <geom class="visual" type="mesh" mesh="RL_hip" rgba="0.18 0.18 0.19 1"/>
        <body name="RL_thigh" pos="0 0.04025 0">
          <inertial pos="-0.00826352 -0.00171733 -0.0468694" mass="0.0505958" fullinertia="0.000106431 0.000114138 1.04375e-05 1.40602e-07 -7.12202e-06 2.68222e-06"/>
          <joint name="RL_thigh_joint" axis="0 1 0" range="-0.2618 2.1817"/>
          <geom class="visual" type="mesh" mesh="RL_thigh" rgba="0.18 0.18 0.19 1"/>
          <geom class="collision" type="capsule" fromto="0 0 -0.02 0 0 -0.1100" size="0.011"/>
          <body name="RL_calf" pos="0 0 -0.129999">
            <inertial pos="0.00157345 -0.000240654 -0.0483317" mass="0.0520587" fullinertia="0.00014983 0.000148959 4.84913e-06 2.87292e-08 4.86705e-06 -1.28311e-07"/>
            <joint name="RL_calf_joint" axis="0 1 0" range="-2.6180 -0.7854"/>
            <geom class="visual" type="mesh" mesh="RL_calf" rgba="0.18 0.18 0.19 1"/>
            <geom class="collision" type="capsule" fromto="0 0 -0.02 0 0 -0.1041" size="0.009"/>
            <geom name="RL_foot" class="collision" type="sphere" pos="0 0 -0.124062" size="0.01198" friction="1.0 0.02 0.001"/>
            <site name="RL_foot" pos="0 0 -0.124062"/>
            <body name="RL_foot" pos="0 0 -0.124062"/>
          </body>
        </body>
      </body>
      <body name="RR_hip" pos="-0.119673 -0.039 -0">
        <inertial pos="0.00918413 -0.0114616 -0.00569384" mass="0.238587" fullinertia="7.2594e-05 6.70427e-05 6.46792e-05 -7.10406e-06 5.33127e-06 1.54244e-05"/>
        <joint name="RR_hip_joint" axis="1 0 0" range="-0.7854 0.3054"/>
        <geom class="visual" type="mesh" mesh="RR_hip" rgba="0.18 0.18 0.19 1"/>
        <body name="RR_thigh" pos="0 -0.04025 0">
          <inertial pos="-0.00825819 0.00172099 -0.0468808" mass="0.0505958" fullinertia="0.00010642 0.000114131 1.04413e-05 -1.40876e-07 -7.10365e-06 -2.67849e-06"/>
          <joint name="RR_thigh_joint" axis="0 1 0" range="-0.2618 2.1817"/>
          <geom class="visual" type="mesh" mesh="RR_thigh" rgba="0.18 0.18 0.19 1"/>
          <geom class="collision" type="capsule" fromto="0 0 -0.02 0 0 -0.1100" size="0.011"/>
          <body name="RR_calf" pos="0 0 -0.129999">
            <inertial pos="0.00157756 0.000225557 -0.0483289" mass="0.0520587" fullinertia="0.000149829 0.000148956 4.85192e-06 -2.48455e-08 4.87482e-06 8.77435e-08"/>
            <joint name="RR_calf_joint" axis="0 1 0" range="-2.6180 -0.7854"/>
            <geom class="visual" type="mesh" mesh="RR_calf" rgba="0.18 0.18 0.19 1"/>
            <geom class="collision" type="capsule" fromto="0 0 -0.02 0 0 -0.1041" size="0.009"/>
            <geom name="RR_foot" class="collision" type="sphere" pos="0 0 -0.124062" size="0.01198" friction="1.0 0.02 0.001"/>
            <site name="RR_foot" pos="0 0 -0.124062"/>
            <body name="RR_foot" pos="0 0 -0.124062"/>
          </body>
        </body>
      </body>
    </body>
  </worldbody>
  <contact><exclude body1="base_link" body2="FL_hip"/><exclude body1="base_link" body2="FR_hip"/><exclude body1="base_link" body2="RL_hip"/><exclude body1="base_link" body2="RR_hip"/></contact>
  <actuator>
    <position class="servo" name="FL_hip" joint="FL_hip_joint"/>
    <position class="servo" name="FL_thigh" joint="FL_thigh_joint"/>
    <position class="servo" name="FL_calf" joint="FL_calf_joint"/>
    <position class="servo" name="FR_hip" joint="FR_hip_joint"/>
    <position class="servo" name="FR_thigh" joint="FR_thigh_joint"/>
    <position class="servo" name="FR_calf" joint="FR_calf_joint"/>
    <position class="servo" name="RL_hip" joint="RL_hip_joint"/>
    <position class="servo" name="RL_thigh" joint="RL_thigh_joint"/>
    <position class="servo" name="RL_calf" joint="RL_calf_joint"/>
    <position class="servo" name="RR_hip" joint="RR_hip_joint"/>
    <position class="servo" name="RR_thigh" joint="RR_thigh_joint"/>
    <position class="servo" name="RR_calf" joint="RR_calf_joint"/>
  </actuator>
  <sensor>
    <framequat name="imu_quat" objtype="site" objname="imu"/>
    <gyro name="imu_gyro" site="imu"/>
    <accelerometer name="imu_acc" site="imu"/>
    <touch name="FL_contact" site="FL_foot"/>
    <touch name="FR_contact" site="FR_foot"/>
    <touch name="RL_contact" site="RL_foot"/>
    <touch name="RR_contact" site="RR_foot"/>
  </sensor>
</mujoco>
