Xpitfire/strido/ros2/strido_description/urdf/strido.urdf

<?xml version="1.0"?>
<!-- GENERATED by strido_cad.models from the verified CAD assembly - do not edit. -->
<robot name="strido">
  <material name="lime"><color rgba="0.78 0.88 0.12 1"/></material>
  <material name="graphite"><color rgba="0.18 0.18 0.19 1"/></material>
  <link name="base_link">
    <visual><geometry><mesh filename="../meshes/base_link.stl"/></geometry><material name="lime"/></visual>
    <collision><origin xyz="-0.000461314 1.9001e-05 0.000601007"/><geometry><box size="0.374091 0.114096 0.0995706"/></geometry></collision>
    <inertial>
      <origin xyz="0.00533714 0.000164431 -0.00651363" rpy="0 0 0"/>
      <mass value="1.70851"/>
      <inertia ixx="0.00261131" ixy="-8.21703e-07" ixz="0.000164474" iyy="0.0137536" iyz="1.70834e-05" izz="0.0137853"/>
    </inertial>
  </link>
  <link name="FL_hip">
    <visual><geometry><mesh filename="../meshes/FL_hip.stl"/></geometry><material name="graphite"/></visual>
    <inertial>
      <origin xyz="0.0082456 0.00976004 -0.00566959" rpy="0 0 0"/>
      <mass value="0.238911"/>
      <inertia ixx="7.15816e-05" ixy="4.56068e-06" ixz="6.63265e-06" iyy="6.67418e-05" iyz="-1.5388e-05" izz="6.32592e-05"/>
    </inertial>
  </link>
  <link name="FL_thigh">
    <visual><geometry><mesh filename="../meshes/FL_thigh.stl"/></geometry><material name="graphite"/></visual>
    <collision><origin xyz="0 0 -0.0649994"/><geometry><cylinder radius="0.011" length="0.129999"/></geometry></collision>
    <inertial>
      <origin xyz="-0.0082624 -0.00171585 -0.0468724" rpy="0 0 0"/>
      <mass value="0.0505958"/>
      <inertia ixx="0.000106437" ixy="1.40387e-07" ixz="-7.12122e-06" iyy="0.000114145" iyz="2.68886e-06" izz="1.04389e-05"/>
    </inertial>
  </link>
  <link name="FL_calf">
    <visual><geometry><mesh filename="../meshes/FL_calf.stl"/></geometry><material name="graphite"/></visual>
    <collision><origin xyz="0 0 -0.0620312"/><geometry><cylinder radius="0.009" length="0.0992499"/></geometry></collision>
    <inertial>
      <origin xyz="0.00157276 -0.00024066 -0.0483311" rpy="0 0 0"/>
      <mass value="0.0520587"/>
      <inertia ixx="0.000149829" ixy="2.85251e-08" ixz="4.86832e-06" iyy="0.000148958" iyz="-1.27588e-07" izz="4.84964e-06"/>
    </inertial>
  </link>
  <link name="FL_foot">
    <collision><geometry><sphere radius="0.0119802"/></geometry></collision>
    <inertial><mass value="0.001"/><inertia ixx="1e-8" ixy="0" ixz="0" iyy="1e-8" iyz="0" izz="1e-8"/></inertial>
  </link>
  <joint name="FL_hip_joint" type="revolute">
    <parent link="base_link"/><child link="FL_hip"/>
    <origin xyz="0.119673 0.039 0" rpy="0 0 0"/><axis xyz="1 0 0"/>
    <limit lower="-0.305433" upper="0.872665" effort="3.432" velocity="7.48"/>
    <dynamics damping="0.05" friction="0.02"/>
  </joint>
  <joint name="FL_thigh_joint" type="revolute">
    <parent link="FL_hip"/><child link="FL_thigh"/>
    <origin xyz="0 0.0382569 0" rpy="0 0 0"/><axis xyz="0 1 0"/>
    <limit lower="-0.698132" upper="2.18166" effort="3.432" velocity="7.48"/>
    <dynamics damping="0.05" friction="0.02"/>
  </joint>
  <joint name="FL_calf_joint" type="revolute">
    <parent link="FL_thigh"/><child link="FL_calf"/>
    <origin xyz="0 0 -0.129999" rpy="0 0 0"/><axis xyz="0 1 0"/>
    <limit lower="-2.61799" upper="-0.785398" effort="3.432" velocity="7.48"/>
    <dynamics damping="0.05" friction="0.02"/>
  </joint>
  <joint name="FL_foot_joint" type="fixed"><parent link="FL_calf"/><child link="FL_foot"/><origin xyz="0 0 -0.124062"/></joint>
  <link name="FR_hip">
    <visual><geometry><mesh filename="../meshes/FR_hip.stl"/></geometry><material name="graphite"/></visual>
    <inertial>
      <origin xyz="0.00824655 -0.00975914 -0.00566936" rpy="0 0 0"/>
      <mass value="0.238911"/>
      <inertia ixx="7.15862e-05" ixy="-4.55375e-06" ixz="6.62781e-06" iyy="6.67299e-05" iyz="1.53861e-05" izz="6.32633e-05"/>
    </inertial>
  </link>
  <link name="FR_thigh">
    <visual><geometry><mesh filename="../meshes/FR_thigh.stl"/></geometry><material name="graphite"/></visual>
    <collision><origin xyz="0 0 -0.0649994"/><geometry><cylinder radius="0.011" length="0.129999"/></geometry></collision>
    <inertial>
      <origin xyz="-0.00825812 0.00172085 -0.0468808" rpy="0 0 0"/>
      <mass value="0.0505958"/>
      <inertia ixx="0.00010642" ixy="-1.40979e-07" ixz="-7.10351e-06" iyy="0.000114131" iyz="-2.67864e-06" izz="1.04414e-05"/>
    </inertial>
  </link>
  <link name="FR_calf">
    <visual><geometry><mesh filename="../meshes/FR_calf.stl"/></geometry><material name="graphite"/></visual>
    <collision><origin xyz="0 0 -0.0620312"/><geometry><cylinder radius="0.009" length="0.0992499"/></geometry></collision>
    <inertial>
      <origin xyz="0.00157633 0.000227239 -0.0483187" rpy="0 0 0"/>
      <mass value="0.0520587"/>
      <inertia ixx="0.000149816" ixy="-2.51644e-08" ixz="4.8755e-06" iyy="0.000148944" iyz="9.5213e-08" izz="4.85095e-06"/>
    </inertial>
  </link>
  <link name="FR_foot">
    <collision><geometry><sphere radius="0.0119802"/></geometry></collision>
    <inertial><mass value="0.001"/><inertia ixx="1e-8" ixy="0" ixz="0" iyy="1e-8" iyz="0" izz="1e-8"/></inertial>
  </link>
  <joint name="FR_hip_joint" type="revolute">
    <parent link="base_link"/><child link="FR_hip"/>
    <origin xyz="0.119673 -0.039 0" rpy="0 0 0"/><axis xyz="1 0 0"/>
    <limit lower="-0.872665" upper="0.305433" effort="3.432" velocity="7.48"/>
    <dynamics damping="0.05" friction="0.02"/>
  </joint>
  <joint name="FR_thigh_joint" type="revolute">
    <parent link="FR_hip"/><child link="FR_thigh"/>
    <origin xyz="0 -0.0382569 0" rpy="0 0 0"/><axis xyz="0 1 0"/>
    <limit lower="-0.698132" upper="2.18166" effort="3.432" velocity="7.48"/>
    <dynamics damping="0.05" friction="0.02"/>
  </joint>
  <joint name="FR_calf_joint" type="revolute">
    <parent link="FR_thigh"/><child link="FR_calf"/>
    <origin xyz="0 0 -0.129999" rpy="0 0 0"/><axis xyz="0 1 0"/>
    <limit lower="-2.61799" upper="-0.785398" effort="3.432" velocity="7.48"/>
    <dynamics damping="0.05" friction="0.02"/>
  </joint>
  <joint name="FR_foot_joint" type="fixed"><parent link="FR_calf"/><child link="FR_foot"/><origin xyz="0 0 -0.124062"/></joint>
  <link name="RL_hip">
    <visual><geometry><mesh filename="../meshes/RL_hip.stl"/></geometry><material name="graphite"/></visual>
    <inertial>
      <origin xyz="0.00918348 0.0114594 -0.00569306" rpy="0 0 0"/>
      <mass value="0.238587"/>
      <inertia ixx="7.25942e-05" ixy="7.1069e-06" ixz="5.32866e-06" iyy="6.70418e-05" iyz="-1.54201e-05" izz="6.4687e-05"/>
    </inertial>
  </link>
  <link name="RL_thigh">
    <visual><geometry><mesh filename="../meshes/RL_thigh.stl"/></geometry><material name="graphite"/></visual>
    <collision><origin xyz="0 0 -0.0649994"/><geometry><cylinder radius="0.011" length="0.129999"/></geometry></collision>
    <inertial>
      <origin xyz="-0.00826352 -0.00171733 -0.0468694" rpy="0 0 0"/>
      <mass value="0.0505958"/>
      <inertia ixx="0.000106431" ixy="1.40602e-07" ixz="-7.12202e-06" iyy="0.000114138" iyz="2.68222e-06" izz="1.04375e-05"/>
    </inertial>
  </link>
  <link name="RL_calf">
    <visual><geometry><mesh filename="../meshes/RL_calf.stl"/></geometry><material name="graphite"/></visual>
    <collision><origin xyz="0 0 -0.0620312"/><geometry><cylinder radius="0.009" length="0.0992499"/></geometry></collision>
    <inertial>
      <origin xyz="0.00157345 -0.000240654 -0.0483317" rpy="0 0 0"/>
      <mass value="0.0520587"/>
      <inertia ixx="0.00014983" ixy="2.87292e-08" ixz="4.86705e-06" iyy="0.000148959" iyz="-1.28311e-07" izz="4.84913e-06"/>
    </inertial>
  </link>
  <link name="RL_foot">
    <collision><geometry><sphere radius="0.0119802"/></geometry></collision>
    <inertial><mass value="0.001"/><inertia ixx="1e-8" ixy="0" ixz="0" iyy="1e-8" iyz="0" izz="1e-8"/></inertial>
  </link>
  <joint name="RL_hip_joint" type="revolute">
    <parent link="base_link"/><child link="RL_hip"/>
    <origin xyz="-0.119673 0.039 -0" rpy="0 0 0"/><axis xyz="1 0 0"/>
    <limit lower="-0.305433" upper="0.785398" effort="3.432" velocity="7.48"/>
    <dynamics damping="0.05" friction="0.02"/>
  </joint>
  <joint name="RL_thigh_joint" type="revolute">
    <parent link="RL_hip"/><child link="RL_thigh"/>
    <origin xyz="0 0.04025 0" rpy="0 0 0"/><axis xyz="0 1 0"/>
    <limit lower="-0.261799" upper="2.18166" effort="3.432" velocity="7.48"/>
    <dynamics damping="0.05" friction="0.02"/>
  </joint>
  <joint name="RL_calf_joint" type="revolute">
    <parent link="RL_thigh"/><child link="RL_calf"/>
    <origin xyz="0 0 -0.129999" rpy="0 0 0"/><axis xyz="0 1 0"/>
    <limit lower="-2.61799" upper="-0.785398" effort="3.432" velocity="7.48"/>
    <dynamics damping="0.05" friction="0.02"/>
  </joint>
  <joint name="RL_foot_joint" type="fixed"><parent link="RL_calf"/><child link="RL_foot"/><origin xyz="0 0 -0.124062"/></joint>
  <link name="RR_hip">
    <visual><geometry><mesh filename="../meshes/RR_hip.stl"/></geometry><material name="graphite"/></visual>
    <inertial>
      <origin xyz="0.00918413 -0.0114616 -0.00569384" rpy="0 0 0"/>
      <mass value="0.238587"/>
      <inertia ixx="7.2594e-05" ixy="-7.10406e-06" ixz="5.33127e-06" iyy="6.70427e-05" iyz="1.54244e-05" izz="6.46792e-05"/>
    </inertial>
  </link>
  <link name="RR_thigh">
    <visual><geometry><mesh filename="../meshes/RR_thigh.stl"/></geometry><material name="graphite"/></visual>
    <collision><origin xyz="0 0 -0.0649994"/><geometry><cylinder radius="0.011" length="0.129999"/></geometry></collision>
    <inertial>
      <origin xyz="-0.00825819 0.00172099 -0.0468808" rpy="0 0 0"/>
      <mass value="0.0505958"/>
      <inertia ixx="0.00010642" ixy="-1.40876e-07" ixz="-7.10365e-06" iyy="0.000114131" iyz="-2.67849e-06" izz="1.04413e-05"/>
    </inertial>
  </link>
  <link name="RR_calf">
    <visual><geometry><mesh filename="../meshes/RR_calf.stl"/></geometry><material name="graphite"/></visual>
    <collision><origin xyz="0 0 -0.0620312"/><geometry><cylinder radius="0.009" length="0.0992499"/></geometry></collision>
    <inertial>
      <origin xyz="0.00157756 0.000225557 -0.0483289" rpy="0 0 0"/>
      <mass value="0.0520587"/>
      <inertia ixx="0.000149829" ixy="-2.48455e-08" ixz="4.87482e-06" iyy="0.000148956" iyz="8.77435e-08" izz="4.85192e-06"/>
    </inertial>
  </link>
  <link name="RR_foot">
    <collision><geometry><sphere radius="0.0119802"/></geometry></collision>
    <inertial><mass value="0.001"/><inertia ixx="1e-8" ixy="0" ixz="0" iyy="1e-8" iyz="0" izz="1e-8"/></inertial>
  </link>
  <joint name="RR_hip_joint" type="revolute">
    <parent link="base_link"/><child link="RR_hip"/>
    <origin xyz="-0.119673 -0.039 -0" rpy="0 0 0"/><axis xyz="1 0 0"/>
    <limit lower="-0.785398" upper="0.305433" effort="3.432" velocity="7.48"/>
    <dynamics damping="0.05" friction="0.02"/>
  </joint>
  <joint name="RR_thigh_joint" type="revolute">
    <parent link="RR_hip"/><child link="RR_thigh"/>
    <origin xyz="0 -0.04025 0" rpy="0 0 0"/><axis xyz="0 1 0"/>
    <limit lower="-0.261799" upper="2.18166" effort="3.432" velocity="7.48"/>
    <dynamics damping="0.05" friction="0.02"/>
  </joint>
  <joint name="RR_calf_joint" type="revolute">
    <parent link="RR_thigh"/><child link="RR_calf"/>
    <origin xyz="0 0 -0.129999" rpy="0 0 0"/><axis xyz="0 1 0"/>
    <limit lower="-2.61799" upper="-0.785398" effort="3.432" velocity="7.48"/>
    <dynamics damping="0.05" friction="0.02"/>
  </joint>
  <joint name="RR_foot_joint" type="fixed"><parent link="RR_calf"/><child link="RR_foot"/><origin xyz="0 0 -0.124062"/></joint>
  <link name="imu_link"/>
  <joint name="imu_link_joint" type="fixed"><parent link="base_link"/><child link="imu_link"/><origin xyz="0.041953 -0.0043 -0.0110833" rpy="0 0 0"/></joint>
  <link name="lidar_link"/>
  <joint name="lidar_link_joint" type="fixed"><parent link="base_link"/><child link="lidar_link"/><origin xyz="-0.034157 0 0.0716167" rpy="0 0 0"/></joint>
  <link name="camera_link"/>
  <joint name="camera_link_joint" type="fixed"><parent link="base_link"/><child link="camera_link"/><origin xyz="0.174153 0 0.0488167" rpy="0 0.261799 0"/></joint>
  <link name="camera_optical_frame"/>
  <joint name="camera_optical_joint" type="fixed"><parent link="camera_link"/><child link="camera_optical_frame"/><origin xyz="0 0 0" rpy="-1.5707963 0 -1.5707963"/></joint>
</robot>
