Xpitfire/strido/hardware/kinematics.yaml

description: Measured from upstream/yertle/design/CAD/Yertle_Single_v2.step by strido_cad.extract_kinematics
units: mm, degrees
base_frame:
  convention: 'REP-103: x forward, y left, z up; origin = centre of the four hip axis intersections'
  origin_in_step_mm:
  - -5.0
  - 20.843
  - 78.6833
  rotation_step_to_base:
  - - 0.0
    - -1.0
    - 0.0
  - - 1.0
    - 0.0
    - 0.0
  - - 0.0
    - 0.0
    - 1.0
legs_step_raw:
  FR:
    servo_output_axis_step:
      hip:
      - -0.0
      - -1.0
      - 0.0
      thigh:
      - -1.0
      - -0.0
      - 0.0
      knee_drive:
      - -1.0
      - 0.0
      - 0.0
    hip_axis_point_step_mm:
    - -43.99999975664726
    - 2.842170943040401e-14
    - 78.7031977887319
    femur_pivot_yz:
    - -98.83010357566347
    - 78.6832650894728
    knee_yz:
    - -6.88810509690848
    - -13.220683765516911
    drive_servo_yz:
    - -118.8119866511607
    - 58.70319778873359
    arm_pin_yz:
    - -135.79764609609614
    - 75.65684806599418
    crank_pin_a_yz:
    - -115.80066632414064
    - 95.6538278379498
    crank_pin_b_yz:
    - -79.75954025733456
    - 97.68324354898112
    tibia_link_end_yz:
    - 10.746055593733873
    - 2.974547434827686
    tibia_pin_yz:
    - 10.082457651568447
    - 3.7498789829593613
    foot_yz:
    - -106.96841445142658
    - -86.53783692714795
    foot_radius_mm: 11.9801796760372
    foot_x_span_mm:
    - -93.30685320696796
    - -71.20685339770283
    leg_plane_x_mm: -82.2568533023354
  RR:
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
    - 127.811
    - 77.257
    - -165.221
  RL:
    hip_mm:
    - -119.673
    - 39.0
    - -0.0
    leg_plane_offset_mm: 40.249999952316365
    knee_in_step_pose_mm:
    - -211.615
    - 79.25
    - -91.904
    foot_in_step_pose_mm:
    - -111.535
    - 79.25
    - -165.221
