Xpitfire/strido/packages/strido-cad/src/strido_cad/models.py

"""Generate the simulation models of Strido from the verified CAD assembly.

Outputs (all regenerated, never hand-edited):
  ros2/strido_description/meshes/<link>.stl     visual meshes per link (vendor parts as convex hulls)
  ros2/strido_description/urdf/strido.urdf     plain URDF, relative mesh paths (PyBullet, MuJoCo, Isaac)
  ros2/strido_description/config/mass_report.yaml  per-link mass/CoM/inertia with the inputs used
  models/mujoco/strido.xml                      MJCF with position servos, IMU and foot sites
The ROS xacro (ros2_control + Gazebo sensors) includes the same link data via
ros2/strido_description/urdf/strido.urdf.xacro, written here as well.

Conventions: REP-103 base frame, Go2 joint names/order, SI units.
"""

import argparse
import math

import numpy as np
import trimesh
import yaml

from strido.gait import REST_HEIGHT_M, stand_pose
from strido.geometry import LEG_NAMES, LEGS

from . import assembly, catalog, parts
from .paths import MASS_PROPERTIES, REPO

DESCRIPTION = REPO / "ros2/strido_description"
MESHES = DESCRIPTION / "meshes"
URDF = DESCRIPTION / "urdf/strido.urdf"
XACRO = DESCRIPTION / "urdf/strido.urdf.xacro"
MASS_REPORT = DESCRIPTION / "config/mass_report.yaml"
MJCF = REPO / "models/mujoco/strido.xml"
SCENE = REPO / "models/mujoco/scene.xml"
SCENE_XML = """<mujoco model="strido scene">
  <!-- GENERATED by strido_cad.models (make models) - do not edit. -->
  <include file="strido.xml"/>
  <statistic center="0 0 0.15" extent="0.6"/>
  <visual><headlight diffuse="0.6 0.6 0.6" ambient="0.3 0.3 0.3" specular="0 0 0"/><global azimuth="135" elevation="-20" offwidth="1280" offheight="720"/></visual>
  <asset>
    <texture type="skybox" builtin="gradient" rgb1="0.85 0.88 0.92" rgb2="0.98 0.98 1" width="512" height="3072"/>
    <texture type="2d" name="groundplane" builtin="checker" mark="edge" rgb1="0.82 0.84 0.86" rgb2="0.74 0.76 0.78" markrgb="0.6 0.6 0.6" width="300" height="300"/>
    <material name="groundplane" texture="groundplane" texuniform="true" texrepeat="5 5" reflectance="0.05"/>
  </asset>
  <worldbody>
    <light pos="0 0 2.5" dir="0 0 -1" directional="true"/>
    <geom name="floor" size="0 0 0.05" type="plane" material="groundplane" friction="1.0 0.02 0.001"/>
  </worldbody>
</mujoco>
"""
INPUTS = yaml.safe_load(MASS_PROPERTIES.read_text())

SERVO_TORQUE_NM = 35.0 * 9.80665 / 100.0  # 35 kg.cm @ 6.0 V (SPT datasheet)
SERVO_SPEED_RAD_S = math.radians(60.0) / 0.14  # 0.14 s / 60 deg @ 6.0 V
VISUAL_FACES_PER_LINK = 25000
MM = 1e-3


def link_of(body: str) -> str:
    if body == "base":
        return "base_link"
    leg, part = body.split(".")
    if part in ("thigh", "long_link"):
        return f"{leg}_thigh"
    if part == "calf":
        return f"{leg}_calf"
    return f"{leg}_hip"  # hip housing, crank, knee-drive arm and short link ride with the hip


def rot_x(angle):
    return trimesh.transformations.rotation_matrix(angle, (1, 0, 0))


def rot_y(angle):
    return trimesh.transformations.rotation_matrix(angle, (0, 1, 0))


def trans(x, y, z):
    matrix = np.eye(4)
    matrix[:3, 3] = (x, y, z)
    return matrix


def link_frames(q: dict) -> dict:
    """Base-frame poses (metres) of every link frame for joint angles q[leg] = (q1, q2, q3)."""
    frames = {"base_link": np.eye(4)}
    for name in LEG_NAMES:
        leg = LEGS[name]
        q1, q2, q3 = q[name]
        hip = trans(leg.hip_x, leg.hip_y, leg.hip_z) @ rot_x(q1)
        thigh = hip @ trans(0, leg.thigh_offset_y, 0) @ rot_y(q2)
        calf = thigh @ trans(0, 0, -leg.thigh_length) @ rot_y(q3)
        frames[f"{name}_hip"] = hip
        frames[f"{name}_thigh"] = thigh
        frames[f"{name}_calf"] = calf
        frames[f"{name}_foot"] = calf @ trans(0, 0, -leg.calf_length)
    return frames


def instance_mass(instance, mesh_mm: trimesh.Trimesh) -> float:
    name = instance.part.split("/")[1]
    if instance.kind == "cable":  # routed length x mass per metre (strido_cad.wiring_geometry)
        return instance.meta["mass_kg"]
    if instance.kind == "printed":
        settings = INPUTS["print_settings"]
        infill = settings["infill_override"].get(name, settings["default_infill"])
        volume = abs(mesh_mm.volume)
        shell = min(volume, mesh_mm.area * settings["wall_mm"])
        return settings["density_g_cm3"] * 1e-3 * (shell + infill * (volume - shell)) / 1000.0
    if name in INPUTS["purchased_kg"]:
        return INPUTS["purchased_kg"][name]
    material = INPUTS["material_of"].get(name) or ("steel" if instance.kind == "fastener" else None)
    assert material, f"no mass source for {instance.part}"
    return INPUTS["density_kg_m3"][material] * abs(mesh_mm.volume) * 1e-9


def combine(parts):
    """parts: list of (mass, com(3), inertia_about_com(3x3)) -> combined (mass, com, inertia)."""
    mass = sum(p[0] for p in parts)
    com = sum(p[0] * p[1] for p in parts) / mass
    inertia = np.zeros((3, 3))
    for m, c, i in parts:
        d = c - com
        inertia += i + m * (np.dot(d, d) * np.eye(3) - np.outer(d, d))
    return mass, com, inertia


def build(instances, base_from_step):
    cad_q = {name: assembly.CAD_POSE[name] for name in LEG_NAMES}
    frames_cad = link_frames(cad_q)
    per_link = {}
    visuals = {}
    for instance in instances:
        if instance.kind == "reference":
            continue
        link = link_of(instance.body)
        mesh_mm = trimesh.load(instance.mesh, force="mesh").copy()
        mass = instance_mass(instance, mesh_mm)
        to_link = np.linalg.inv(frames_cad[link])
        placed = mesh_mm.copy()
        placed.apply_transform(base_from_step @ instance.matrix)
        placed.apply_scale(MM)
        placed.apply_transform(to_link)
        volume = abs(placed.volume) if placed.is_volume else None
        if volume and volume > 1e-12:
            density = mass / volume
            inertia = placed.moment_inertia * density
            com = placed.center_mass
        else:  # open vendor meshes: treat as a point mass at the bounds centre
            inertia = np.zeros((3, 3))
            com = placed.bounds.mean(axis=0)
        per_link.setdefault(link, []).append((mass, np.asarray(com), np.asarray(inertia)))
        if instance.kind == "cable":
            continue  # mass only: thin tubes add nothing to the simulation visuals
        visual = (
            placed
            if instance.kind != "purchased" or "servo" in instance.part or "bearing" in instance.part
            else placed.convex_hull
        )
        visuals.setdefault(link, []).append(visual)
    consumables = INPUTS["consumables_kg"]
    per_link["base_link"].append((consumables, np.zeros(3), np.eye(3) * consumables * 0.03**2))
    properties = {link: combine(parts) for link, parts in per_link.items()}
    return properties, visuals


def write_meshes(visuals):
    MESHES.mkdir(parents=True, exist_ok=True)
    for link, meshes in visuals.items():
        merged = trimesh.util.concatenate(meshes)
        if len(merged.faces) > VISUAL_FACES_PER_LINK:
            merged = merged.simplify_quadric_decimation(face_count=VISUAL_FACES_PER_LINK)
        merged.export(MESHES / f"{link}.stl")


def fmt(values):
    return " ".join(f"{float(v):.6g}" for v in values)


def inertial_xml(properties, link, indent="    "):
    mass, com, inertia = properties[link]
    i = inertia
    return (
        f'{indent}<inertial>\n{indent}  <origin xyz="{fmt(com)}" rpy="0 0 0"/>\n{indent}  <mass value="{mass:.6g}"/>\n'
        f'{indent}  <inertia ixx="{i[0, 0]:.6g}" ixy="{i[0, 1]:.6g}" ixz="{i[0, 2]:.6g}" iyy="{i[1, 1]:.6g}" iyz="{i[1, 2]:.6g}" izz="{i[2, 2]:.6g}"/>\n'
        f"{indent}</inertial>\n"
    )


def sensor_frames(base_from_step):
    """Base-frame poses of IMU, LiDAR and camera from the Strido part placements."""

    def to_base(point_mm):
        return (base_from_step @ np.append(point_mm, 1.0))[:3] * MM

    imu_centre = parts.IMU_BOARD_ORIGIN + np.array([12.7, 8.89, 1.6])
    cx, cy = parts.LIDAR_CENTRE
    lidar = np.array([cx, cy, parts.TOP_OUTER_Z + parts.PEDESTAL_HEIGHT + 29.8])
    camera = np.array([-5.0, parts.CAMERA_PCB_BACK_Y - 8.81, parts.CAMERA_LENS_Z])
    return {
        "imu_link": (to_base(imu_centre), (0.0, 0.0, 0.0)),
        "lidar_link": (to_base(lidar), (0.0, 0.0, 0.0)),
        "camera_link": (to_base(camera), (0.0, math.radians(parts.CAMERA_TILT_DEG), 0.0)),
    }


def body_box(properties_visual_base: trimesh.Trimesh):
    lo, hi = properties_visual_base.bounds
    return (lo + hi) / 2, hi - lo


def urdf_text(properties, sensors, base_box, mesh_prefix: str) -> str:
    lines = [
        '<?xml version="1.0"?>',
        "<!-- GENERATED by strido_cad.models from the verified CAD assembly - do not edit. -->",
        '<robot name="strido">',
        '  <material name="lime"><color rgba="0.78 0.88 0.12 1"/></material>',
        '  <material name="graphite"><color rgba="0.18 0.18 0.19 1"/></material>',
    ]
    centre, size = base_box
    lines.append('  <link name="base_link">')
    lines.append(
        f'    <visual><geometry><mesh filename="{mesh_prefix}base_link.stl"/></geometry><material name="lime"/></visual>'
    )
    lines.append(
        f'    <collision><origin xyz="{fmt(centre)}"/><geometry><box size="{fmt(size)}"/></geometry></collision>'
    )
    lines.append(inertial_xml(properties, "base_link").rstrip("\n"))
    lines.append("  </link>")
    for name in LEG_NAMES:
        leg = LEGS[name]
        hip, thigh, calf = f"{name}_hip", f"{name}_thigh", f"{name}_calf"
        limits = {
            "hip": (leg.hip_min, leg.hip_max),
            "thigh": (leg.thigh_min, leg.thigh_max),
            "calf": (leg.calf_min, leg.calf_max),
        }
        for link in (hip, thigh, calf):
            lines.append(f'  <link name="{link}">')
            lines.append(
                f'    <visual><geometry><mesh filename="{mesh_prefix}{link}.stl"/></geometry><material name="graphite"/></visual>'
            )
            if link == thigh:
                lines.append(
                    f'    <collision><origin xyz="0 0 {-leg.thigh_length / 2:.6g}"/><geometry><cylinder radius="0.011" length="{leg.thigh_length:.6g}"/></geometry></collision>'
                )
            if link == calf:
                lines.append(
                    f'    <collision><origin xyz="0 0 {-leg.calf_length / 2:.6g}"/><geometry><cylinder radius="0.009" length="{leg.calf_length * 0.8:.6g}"/></geometry></collision>'
                )
            lines.append(inertial_xml(properties, link).rstrip("\n"))
            lines.append("  </link>")
        lines.append(f'  <link name="{name}_foot">')
        lines.append(f'    <collision><geometry><sphere radius="{leg.foot_radius:.6g}"/></geometry></collision>')
        lines.append(
            '    <inertial><mass value="0.001"/><inertia ixx="1e-8" ixy="0" ixz="0" iyy="1e-8" iyz="0" izz="1e-8"/></inertial>'
        )
        lines.append("  </link>")
        joints = (
            (f"{name}_hip_joint", "base_link", hip, (leg.hip_x, leg.hip_y, leg.hip_z), (1, 0, 0), limits["hip"]),
            (f"{name}_thigh_joint", hip, thigh, (0, leg.thigh_offset_y, 0), (0, 1, 0), limits["thigh"]),
            (f"{name}_calf_joint", thigh, calf, (0, 0, -leg.thigh_length), (0, 1, 0), limits["calf"]),
        )
        for joint, parent, child, origin, axis, (low, high) in joints:
            lines.append(f'  <joint name="{joint}" type="revolute">')
            lines.append(f'    <parent link="{parent}"/><child link="{child}"/>')
            lines.append(f'    <origin xyz="{fmt(origin)}" rpy="0 0 0"/><axis xyz="{fmt(axis)}"/>')
            lines.append(
                f'    <limit lower="{low:.6g}" upper="{high:.6g}" effort="{SERVO_TORQUE_NM:.4g}" velocity="{SERVO_SPEED_RAD_S:.4g}"/>'
            )
            lines.append('    <dynamics damping="0.05" friction="0.02"/>')
            lines.append("  </joint>")
        lines.append(
            f'  <joint name="{name}_foot_joint" type="fixed"><parent link="{calf}"/><child link="{name}_foot"/>'
            f'<origin xyz="0 0 {-leg.calf_length:.6g}"/></joint>'
        )
    for frame, (xyz, rpy) in sensors.items():
        lines.append(f'  <link name="{frame}"/>')
        lines.append(
            f'  <joint name="{frame}_joint" type="fixed"><parent link="base_link"/><child link="{frame}"/>'
            f'<origin xyz="{fmt(xyz)}" rpy="{fmt(rpy)}"/></joint>'
        )
    lines.append('  <link name="camera_optical_frame"/>')
    lines.append(
        '  <joint name="camera_optical_joint" type="fixed"><parent link="camera_link"/><child link="camera_optical_frame"/>'
        '<origin xyz="0 0 0" rpy="-1.5707963 0 -1.5707963"/></joint>'
    )
    lines.append("</robot>")
    return "\n".join(lines) + "\n"


def mjcf_text(properties, sensors, base_box) -> str:
    """MuJoCo model: same kinematics/inertias; hobby-servo position actuators."""
    stand = 0.17
    centre, size = base_box
    out = [
        '<mujoco model="strido">',
        "  <!-- GENERATED by strido_cad.models - do not edit. -->",
        '  <compiler angle="radian" meshdir="../../ros2/strido_description/meshes" autolimits="true"/>',
        '  <option timestep="0.002" integrator="implicitfast"/>',
        "  <default>",
        '    <default class="servo">',
        '      <joint damping="0.25" armature="0.012" frictionloss="0.05"/>',
        f'      <position kp="25" kv="0.4" forcerange="{-SERVO_TORQUE_NM:.3f} {SERVO_TORQUE_NM:.3f}" inheritrange="1"/>',
        "    </default>",
        '    <default class="visual"><geom contype="0" conaffinity="0" group="2"/></default>',
        '    <default class="collision"><geom group="3" friction="0.9 0.02 0.001"/></default>',
        "  </default>",
        "  <asset>",
    ]
    links = ["base_link"] + [f"{n}_{p}" for n in LEG_NAMES for p in ("hip", "thigh", "calf")]
    for link in links:
        out.append(f'    <mesh name="{link}" file="{link}.stl"/>')
    out += [
        "  </asset>",
        "  <worldbody>",
        f'    <body name="base_link" pos="0 0 {stand + 0.03:.3f}" childclass="servo">',
        '      <freejoint name="root"/>',
    ]

    def inertial(link, indent):
        mass, com, inertia = properties[link]
        values = [inertia[0, 0], inertia[1, 1], inertia[2, 2], inertia[0, 1], inertia[0, 2], inertia[1, 2]]
        return f'{indent}<inertial pos="{fmt(com)}" mass="{mass:.6g}" fullinertia="{fmt(values)}"/>'

    out.append(inertial("base_link", "      "))
    out.append('      <geom class="visual" type="mesh" mesh="base_link" rgba="0.78 0.88 0.12 1"/>')
    out.append(f'      <geom class="collision" type="box" pos="{fmt(centre)}" size="{fmt(size / 2)}"/>')
    imu_xyz = sensors["imu_link"][0]
    out.append(f'      <site name="imu" pos="{fmt(imu_xyz)}"/>')
    lidar_xyz = sensors["lidar_link"][0]
    out.append(f'      <site name="lidar" pos="{fmt(lidar_xyz)}"/>')
    for name in LEG_NAMES:
        leg = LEGS[name]
        out.append(f'      <body name="{name}_hip" pos="{fmt((leg.hip_x, leg.hip_y, leg.hip_z))}">')
        out.append(inertial(f"{name}_hip", "        "))
        out.append(f'        <joint name="{name}_hip_joint" axis="1 0 0" range="{leg.hip_min:.4f} {leg.hip_max:.4f}"/>')
        out.append(f'        <geom class="visual" type="mesh" mesh="{name}_hip" rgba="0.18 0.18 0.19 1"/>')
        out.append(f'        <body name="{name}_thigh" pos="0 {leg.thigh_offset_y:.6g} 0">')
        out.append(inertial(f"{name}_thigh", "          "))
        out.append(
            f'          <joint name="{name}_thigh_joint" axis="0 1 0" range="{leg.thigh_min:.4f} {leg.thigh_max:.4f}"/>'
        )
        out.append(f'          <geom class="visual" type="mesh" mesh="{name}_thigh" rgba="0.18 0.18 0.19 1"/>')
        out.append(
            f'          <geom class="collision" type="capsule" fromto="0 0 -0.02 0 0 {-leg.thigh_length + 0.02:.4f}" size="0.011"/>'
        )
        out.append(f'          <body name="{name}_calf" pos="0 0 {-leg.thigh_length:.6g}">')
        out.append(inertial(f"{name}_calf", "            "))
        out.append(
            f'            <joint name="{name}_calf_joint" axis="0 1 0" range="{leg.calf_min:.4f} {leg.calf_max:.4f}"/>'
        )
        out.append(f'            <geom class="visual" type="mesh" mesh="{name}_calf" rgba="0.18 0.18 0.19 1"/>')
        out.append(
            f'            <geom class="collision" type="capsule" fromto="0 0 -0.02 0 0 {-leg.calf_length + 0.02:.4f}" size="0.009"/>'
        )
        out.append(
            f'            <geom name="{name}_foot" class="collision" type="sphere" pos="0 0 {-leg.calf_length:.6g}" size="{leg.foot_radius:.5f}" friction="1.0 0.02 0.001"/>'
        )
        out.append(f'            <site name="{name}_foot" pos="0 0 {-leg.calf_length:.6g}"/>')
        out.append(
            f'            <body name="{name}_foot" pos="0 0 {-leg.calf_length:.6g}"/>'
        )  # foot frame (NT-X, URDF parity)
        out += ["          </body>", "        </body>", "      </body>"]
    out += [
        "    </body>",
        "  </worldbody>",
        '  <contact><exclude body1="base_link" body2="FL_hip"/><exclude body1="base_link" body2="FR_hip"/>'
        '<exclude body1="base_link" body2="RL_hip"/><exclude body1="base_link" body2="RR_hip"/></contact>',
        "  <actuator>",
    ]
    for name in LEG_NAMES:
        for joint in ("hip", "thigh", "calf"):
            out.append(f'    <position class="servo" name="{name}_{joint}" joint="{name}_{joint}_joint"/>')
    out += [
        "  </actuator>",
        "  <sensor>",
        '    <framequat name="imu_quat" objtype="site" objname="imu"/>',
        '    <gyro name="imu_gyro" site="imu"/>',
        '    <accelerometer name="imu_acc" site="imu"/>',
    ]
    for name in LEG_NAMES:
        out.append(f'    <touch name="{name}_contact" site="{name}_foot"/>')
    out += ["  </sensor>", "</mujoco>"]
    return "\n".join(out) + "\n"


def main():
    parser = argparse.ArgumentParser()
    parser.add_argument("--skip-meshes", action="store_true")
    args = parser.parse_args()
    instances = catalog.full_assembly()
    base_from_step = assembly.step_to_base()
    properties, visuals = build(instances, base_from_step)
    body_mesh = trimesh.util.concatenate([m for m in visuals["base_link"]])
    shell_box = body_box(trimesh.util.concatenate([m for m in visuals["base_link"] if m.bounds[1][2] < 0.06]))
    del body_mesh
    if not args.skip_meshes:
        write_meshes(visuals)
    sensors = sensor_frames(base_from_step)
    URDF.parent.mkdir(parents=True, exist_ok=True)
    URDF.write_text(urdf_text(properties, sensors, shell_box, "../meshes/"))
    XACRO.write_text(xacro_text(urdf_text(properties, sensors, shell_box, "package://strido_description/meshes/")))
    MJCF.parent.mkdir(parents=True, exist_ok=True)
    MJCF.write_text(mjcf_text(properties, sensors, shell_box))
    SCENE.write_text(SCENE_XML)
    report = {}
    total = 0.0
    for link, (mass, com, inertia) in sorted(properties.items()):
        total += mass
        report[link] = {
            "mass_kg": round(float(mass), 4),
            "com_m": [round(float(v), 5) for v in com],
            "inertia_kg_m2": [[float(f"{v:.6g}") for v in row] for row in inertia],
        }
    MASS_REPORT.parent.mkdir(parents=True, exist_ok=True)
    MASS_REPORT.write_text(
        yaml.safe_dump(
            {"total_mass_kg": round(float(total), 4), "links": report, "inputs": "hardware/mass_properties.yaml"},
            sort_keys=False,
        )
    )
    print(f"total mass {total:.3f} kg; base {properties['base_link'][0]:.3f} kg")


def xacro_text(plain: str) -> str:
    """Wrap the generated links/joints with ros2_control and Gazebo Harmonic sensors."""
    body = plain.split('<robot name="strido">', 1)[1].rsplit("</robot>", 1)[0]
    joints = [f"{leg}_{j}_joint" for leg in LEG_NAMES for j in ("hip", "thigh", "calf")]
    # Simulation only: on the real robot strido_control/mcu_bridge publishes /joint_states and consumes
    # the same /leg_controller/commands topic, so no ros2_control hardware plugin is needed.
    control = [
        '  <xacro:arg name="sim" default="false"/>',
        '  <xacro:if value="$(arg sim)">',
        '  <ros2_control name="strido" type="system">',
        "    <hardware><plugin>gz_ros2_control/GazeboSimSystem</plugin></hardware>",
    ]
    rest = stand_pose(REST_HEIGHT_M)  # spawn folded, inside the joint limits (zero is outside the knee range)
    for joint, initial in zip(joints, rest):
        control += [
            f'    <joint name="{joint}">',
            '      <command_interface name="position"/>',
            f'      <state_interface name="position"><param name="initial_value">{initial:.4f}</param></state_interface>',
            '      <state_interface name="velocity"/>',
            "    </joint>",
        ]
    control += ["  </ros2_control>", "  </xacro:if>"]
    gazebo = [
        '  <xacro:if value="$(arg sim)">',
        '    <gazebo><plugin filename="gz_ros2_control-system" name="gz_ros2_control::GazeboSimROS2ControlPlugin">'
        "<parameters>$(find strido_description)/config/controllers.yaml</parameters></plugin></gazebo>",
        '    <gazebo><plugin filename="gz-sim-odometry-publisher-system" name="gz::sim::systems::OdometryPublisher">'
        "<odom_frame>odom</odom_frame><robot_base_frame>base_link</robot_base_frame><odom_topic>ground_truth/odom</odom_topic>"
        "<odom_publish_frequency>50</odom_publish_frequency><dimensions>3</dimensions></plugin></gazebo>",
        '    <gazebo reference="imu_link"><sensor name="imu_sensor" type="imu"><always_on>1</always_on><update_rate>200</update_rate>'
        "<topic>imu/data</topic><gz_frame_id>imu_link</gz_frame_id></sensor></gazebo>",
        '    <gazebo reference="lidar_link"><sensor name="lidar" type="gpu_lidar"><update_rate>10</update_rate><topic>scan</topic>'
        "<gz_frame_id>lidar_link</gz_frame_id><lidar><scan><horizontal><samples>360</samples><min_angle>-3.14159</min_angle>"
        "<max_angle>3.14159</max_angle></horizontal></scan><range><min>0.05</min><max>12.0</max></range>"
        "<noise><type>gaussian</type><mean>0</mean><stddev>0.01</stddev></noise></lidar><always_on>1</always_on></sensor></gazebo>",
        '    <gazebo reference="camera_link"><sensor name="camera" type="camera"><update_rate>15</update_rate><topic>camera/image_raw</topic>'
        "<gz_frame_id>camera_optical_frame</gz_frame_id><camera><horizontal_fov>1.78</horizontal_fov><image><width>640</width>"
        "<height>360</height></image><clip><near>0.05</near><far>20</far></clip></camera><always_on>1</always_on></sensor></gazebo>",
    ]
    for leg in LEG_NAMES:
        gazebo.append(
            f'    <gazebo reference="{leg}_foot"><mu1>1.0</mu1><mu2>1.0</mu2><kp>100000</kp><kd>10</kd></gazebo>'
        )
    gazebo.append("  </xacro:if>")
    return (
        '<?xml version="1.0"?>\n<!-- GENERATED by strido_cad.models - do not edit. -->\n'
        '<robot name="strido" xmlns:xacro="http://www.ros.org/wiki/xacro">\n'
        + "\n".join(control)
        + "\n"
        + "\n".join(gazebo)
        + body
        + "</robot>\n"
    )


if __name__ == "__main__":
    main()
